mcesar67/MCboard/examples/classic_64x20/MCboard_64x20.pdf

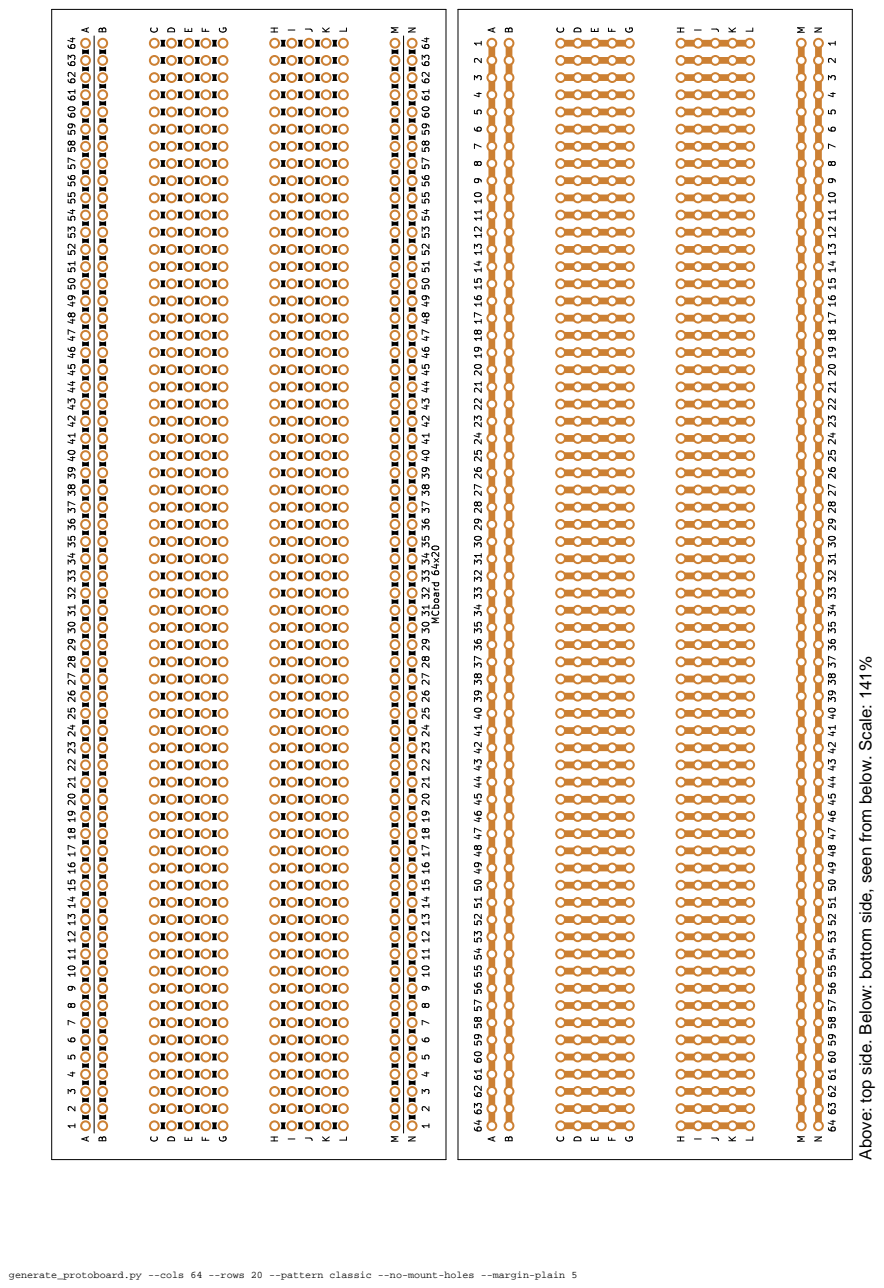
[picture p4: page 1]

Above: top side. Below: bottom side, seen from below. Scale: 141%

generate_protoboard.py --cols 64 --rows 20 --pattern classic --no-mount-holes --margin-plain 5
