mcesar67/MCboard/examples/default_30x19/MCboard_30x19.pdf

## Top and bottom: 2 holes each, centres 75 mm apart, strips 56.72 mm apart

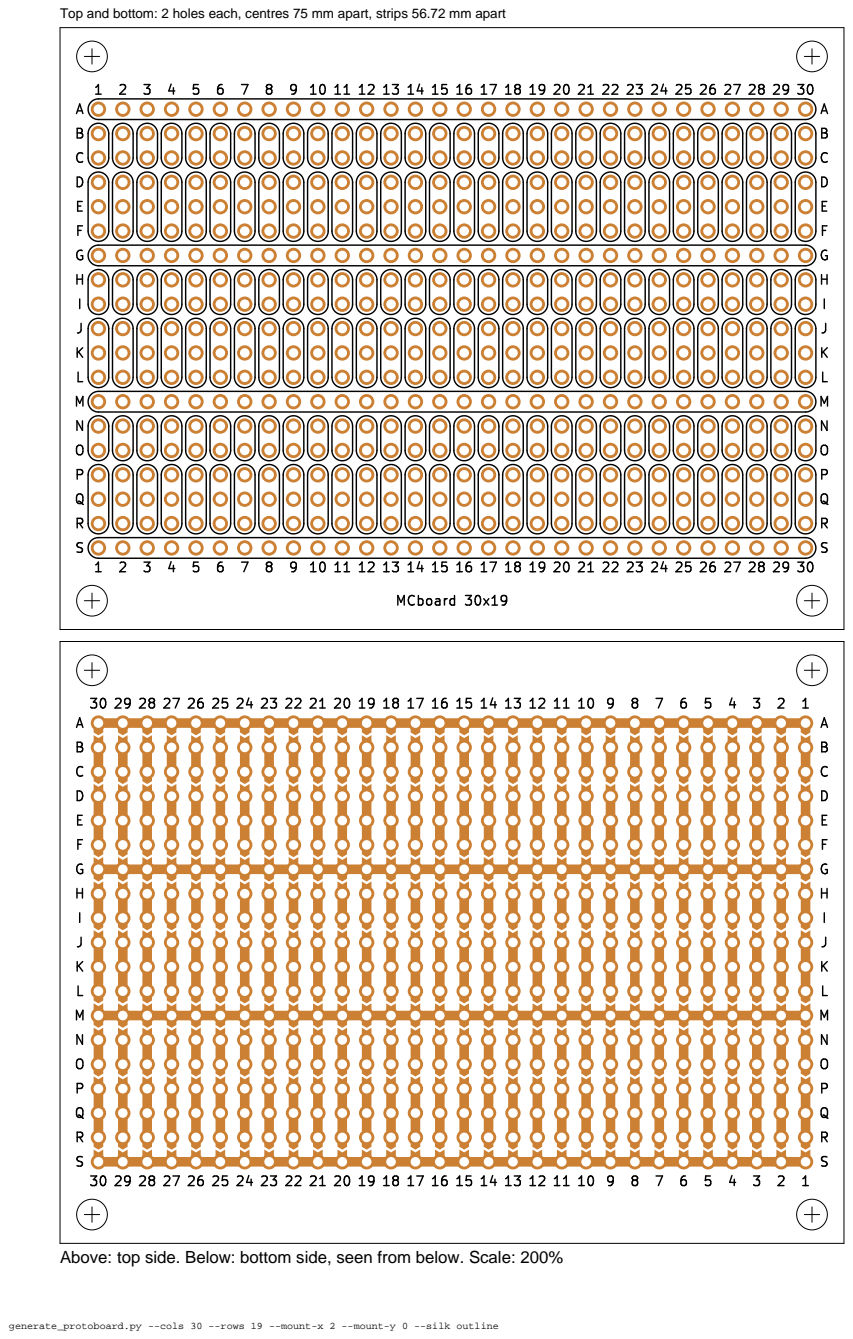
[picture p5: page 1]

Above: top side. Below: bottom side, seen from below. Scale: 200%

generate_protoboard.py --cols 30 --rows 19 --mount-x 2 --mount-y 0 --silk outline
