mcesar67/MCboard/examples/default_30x19/MCboard_30x19.kicad_pcb

## KiCad design examples/default_30x19/MCboard_30x19.kicad_pcb (2026-11-11)

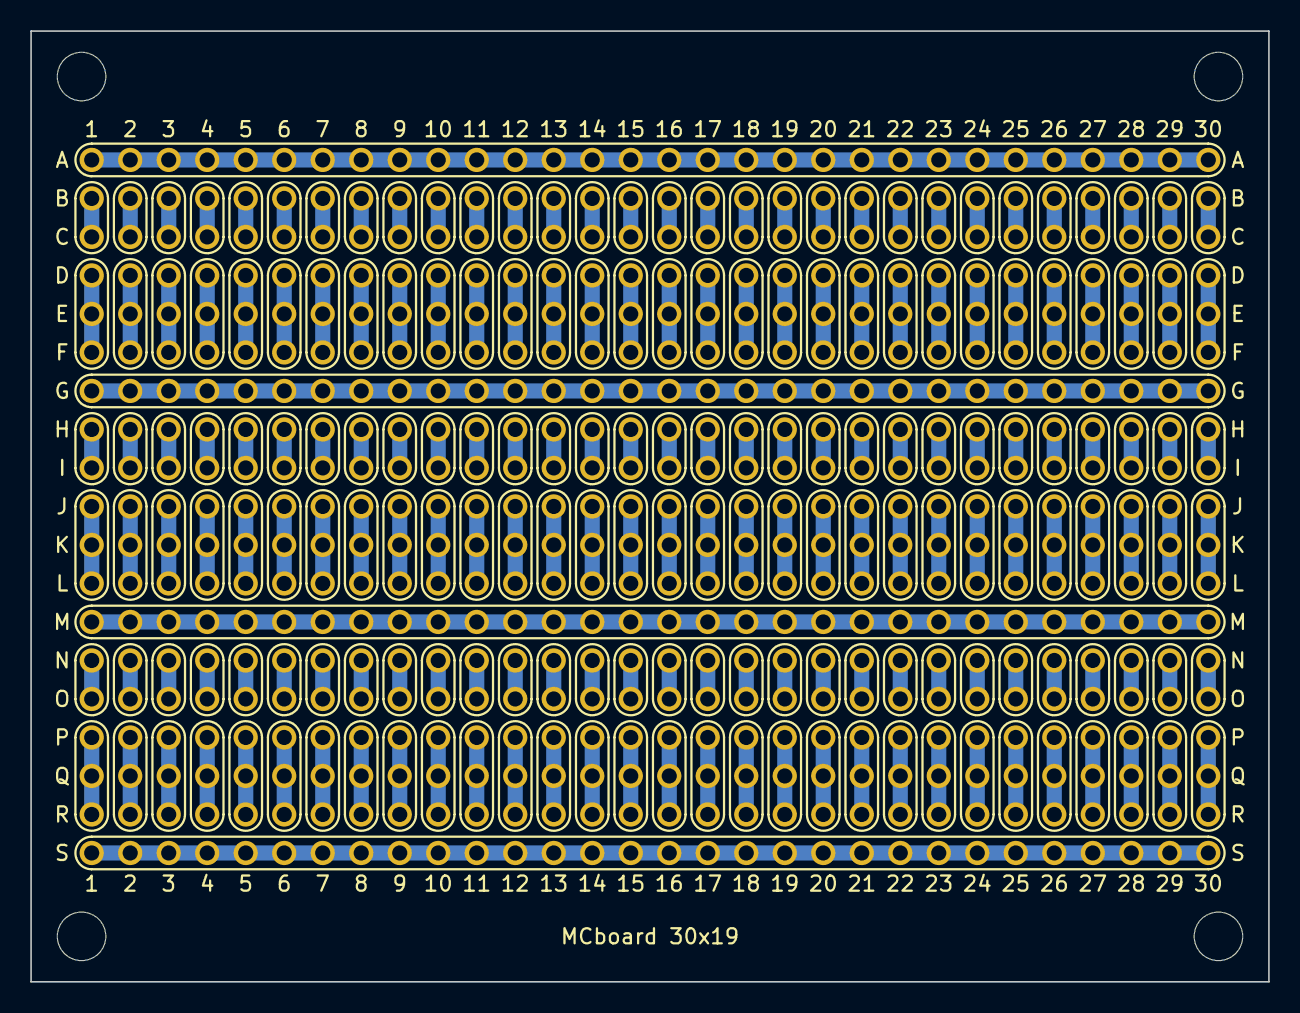
[picture p6: board examples/default_30x19/MCboard_30x19.kicad_pcb from above]

Board: 2 copper layers, 81.7 x 62.7 mm, 844 parts (0 on the bottom side), 184 nets.

Parts:
PBH1, PBH2, PBH3, PBH4, PBH5, PBH6, PBH7, PBH8, PBH9, PBH10, PBH11, PBH12, PBH13, PBH14, PBH15, PBH16, PBH17, PBH18, PBH19, PBH20, PBH21, PBH22, PBH23, PBH24, PBH25, PBH26, PBH27, PBH28, PBH29, PBH30, PBH31, PBH32, PBH33, PBH34, PBH35, PBH36, PBH37, PBH38, PBH39, PBH40, PBH41, PBH42, PBH43, PBH44, PBH45, PBH46, PBH47, PBH48, PBH49, PBH50, PBH51, PBH52, PBH53, PBH54, PBH55, PBH56, PBH57, PBH58, PBH59, PBH60, PBH61, PBH62, PBH63, PBH64, PBH65, PBH66, PBH67, PBH68, PBH69, PBH70, PBH71, PBH72, PBH73, PBH74, PBH75, PBH76, PBH77, PBH78, PBH79, PBH80, PBH81, PBH82, PBH83, PBH84, PBH85, PBH86, PBH87, PBH88, PBH89, PBH90, PBH91, PBH92, PBH93, PBH94, PBH95, PBH96, PBH97, PBH98, PBH99, PBH100, PBH101, PBH102, PBH103, PBH104, PBH105, PBH106, PBH107, PBH108, PBH109, PBH110, PBH111, PBH112, PBH113, PBH114, PBH115, PBH116, PBH117, PBH118, PBH119, PBH120, PBH121, PBH122, PBH123, PBH124, PBH125, PBH126, PBH127, PBH128, PBH129, PBH130, PBH131, PBH132, PBH133, PBH134, PBH135, PBH136, PBH137, PBH138, PBH139, PBH140, PBH141, PBH142, PBH143, PBH144, PBH145, PBH146, PBH147, PBH148, PBH149, PBH150, PBH151, PBH152, PBH153, PBH154, PBH155, PBH156, PBH157, PBH158, PBH159, PBH160, PBH161, PBH162, PBH163, PBH164, PBH165, PBH166, PBH167, PBH168, PBH169, PBH170, PBH171, PBH172, PBH173, PBH174, PBH175, PBH176, PBH177, PBH178, PBH179, PBH180, PBH181, PBH182, PBH183, PBH184, PBH185, PBH186, PBH187, PBH188, PBH189, PBH190, PBH191, PBH192, PBH193, PBH194, PBH195, PBH196, PBH197, PBH198, PBH199, PBH200, PBH201, PBH202, PBH203, PBH204, PBH205, PBH206, PBH207, PBH208, PBH209, PBH210, PBH211, PBH212, PBH213, PBH214, PBH215, PBH216, PBH217, PBH218, PBH219, PBH220, PBH221, PBH222, PBH223, PBH224, PBH225, PBH226, PBH227, PBH228, PBH229, PBH230, PBH231, PBH232, PBH233, PBH234, PBH235, PBH236, PBH237, PBH238, PBH239, PBH240, PBH241, PBH242, PBH243, PBH244, PBH245, PBH246, PBH247, PBH248, PBH249, PBH250, PBH251, PBH252, PBH253, PBH254, PBH255, PBH256, PBH257, PBH258, PBH259, PBH260, PBH261, PBH262, PBH263, PBH264, PBH265, PBH266, PBH267, PBH268, PBH269, PBH270, PBH271, PBH272, PBH273, PBH274, PBH275, PBH276, PBH277, PBH278, PBH279, PBH280, PBH281, PBH282, PBH283, PBH284, PBH285, PBH286, PBH287, PBH288, PBH289, PBH290, PBH291, PBH292, PBH293, PBH294, PBH295, PBH296, PBH297, PBH298, PBH299, PBH300, PBH301, PBH302, PBH303, PBH304, PBH305, PBH306, PBH307, PBH308, PBH309, PBH310, PBH311, PBH312, PBH313, PBH314, PBH315, PBH316, PBH317, PBH318, PBH319, PBH320, PBH321, PBH322, PBH323, PBH324, PBH325, PBH326, PBH327, PBH328, PBH329, PBH330, PBH331, PBH332, PBH333, PBH334, PBH335, PBH336, PBH337, PBH338, PBH339, PBH340, PBH341, PBH342, PBH343, PBH344, PBH345, PBH346, PBH347, PBH348, PBH349, PBH350, PBH351, PBH352, PBH353, PBH354, PBH355, PBH356, PBH357, PBH358, PBH359, PBH360, PBH361, PBH362, PBH363, PBH364, PBH365, PBH366, PBH367, PBH368, PBH369, PBH370, PBH371, PBH372, PBH373, PBH374, PBH375, PBH376, PBH377, PBH378, PBH379, PBH380, PBH381, PBH382, PBH383, PBH384, PBH385, PBH386, PBH387, PBH388, PBH389, PBH390, PBH391, PBH392, PBH393, PBH394, PBH395, PBH396, PBH397, PBH398, PBH399, PBH400, PBH401, PBH402, PBH403, PBH404, PBH405, PBH406, PBH407, PBH408, PBH409, PBH410, PBH411, PBH412, PBH413, PBH414, PBH415, PBH416, PBH417, PBH418, PBH419, PBH420, PBH421, PBH422, PBH423, PBH424, PBH425, PBH426, PBH427, PBH428, PBH429, PBH430, PBH431, PBH432, PBH433, PBH434, PBH435, PBH436, PBH437, PBH438, PBH439, PBH440, PBH441, PBH442, PBH443, PBH444, PBH445, PBH446, PBH447, PBH448, PBH449, PBH450, PBH451, PBH452, PBH453, PBH454, PBH455, PBH456, PBH457, PBH458, PBH459, PBH460, PBH461, PBH462, PBH463, PBH464, PBH465, PBH466, PBH467, PBH468, PBH469, PBH470, PBH471, PBH472, PBH473, PBH474, PBH475, PBH476, PBH477, PBH478, PBH479, PBH480, PBH481, PBH482, PBH483, PBH484, PBH485, PBH486, PBH487, PBH488, PBH489, PBH490, PBH491, PBH492, PBH493, PBH494, PBH495, PBH496, PBH497, PBH498, PBH499, PBH500, PBH501, PBH502, PBH503, PBH504, PBH505, PBH506, PBH507, PBH508, PBH509, PBH510, PBH511, PBH512, PBH513, PBH514, PBH515, PBH516, PBH517, PBH518, PBH519, PBH520, PBH521, PBH522, PBH523, PBH524, PBH525, PBH526, PBH527, PBH528, PBH529, PBH530, PBH531, PBH532, PBH533, PBH534, PBH535, PBH536, PBH537, PBH538, PBH539, PBH540, PBH541, PBH542, PBH543, PBH544, PBH545, PBH546, PBH547, PBH548, PBH549, PBH550, PBH551, PBH552, PBH553, PBH554, PBH555, PBH556, PBH557, PBH558, PBH559, PBH560, PBH561, PBH562, PBH563, PBH564, PBH565, PBH566, PBH567, PBH568, PBH569, PBH570: hole; Hole
PBJP1, PBJP2, PBJP3, PBJP4, PBJP5, PBJP6, PBJP7, PBJP8, PBJP9, PBJP10, PBJP11, PBJP12, PBJP13, PBJP14, PBJP15, PBJP16, PBJP17, PBJP18, PBJP19, PBJP20, PBJP21, PBJP22, PBJP23, PBJP24, PBJP25, PBJP26, PBJP27, PBJP28, PBJP29, PBJP30, PBJP31, PBJP32, PBJP33, PBJP34, PBJP35, PBJP36, PBJP37, PBJP38, PBJP39, PBJP40, PBJP41, PBJP42, PBJP43, PBJP44, PBJP45, PBJP46, PBJP47, PBJP48, PBJP49, PBJP50, PBJP51, PBJP52, PBJP53, PBJP54, PBJP55, PBJP56, PBJP57, PBJP58, PBJP59, PBJP60, PBJP61, PBJP62, PBJP63, PBJP64, PBJP65, PBJP66, PBJP67, PBJP68, PBJP69, PBJP70, PBJP71, PBJP72, PBJP73, PBJP74, PBJP75, PBJP76, PBJP77, PBJP78, PBJP79, PBJP80, PBJP81, PBJP82, PBJP83, PBJP84, PBJP85, PBJP86, PBJP87, PBJP88, PBJP89, PBJP90, PBJP91, PBJP92, PBJP93, PBJP94, PBJP95, PBJP96, PBJP97, PBJP98, PBJP99, PBJP100, PBJP101, PBJP102, PBJP103, PBJP104, PBJP105, PBJP106, PBJP107, PBJP108, PBJP109, PBJP110, PBJP111, PBJP112, PBJP113, PBJP114, PBJP115, PBJP116, PBJP117, PBJP118, PBJP119, PBJP120, PBJP121, PBJP122, PBJP123, PBJP124, PBJP125, PBJP126, PBJP127, PBJP128, PBJP129, PBJP130, PBJP131, PBJP132, PBJP133, PBJP134, PBJP135, PBJP136, PBJP137, PBJP138, PBJP139, PBJP140, PBJP141, PBJP142, PBJP143, PBJP144, PBJP145, PBJP146, PBJP147, PBJP148, PBJP149, PBJP150, PBJP151, PBJP152, PBJP153, PBJP154, PBJP155, PBJP156, PBJP157, PBJP158, PBJP159, PBJP160, PBJP161, PBJP162, PBJP163, PBJP164, PBJP165, PBJP166, PBJP167, PBJP168, PBJP169, PBJP170, PBJP171, PBJP172, PBJP173, PBJP174, PBJP175, PBJP176, PBJP177, PBJP178, PBJP179, PBJP180, PBJP181, PBJP182, PBJP183, PBJP184, PBJP185, PBJP186, PBJP187, PBJP188, PBJP189, PBJP190, PBJP191, PBJP192, PBJP193, PBJP194, PBJP195, PBJP196, PBJP197, PBJP198, PBJP199, PBJP200, PBJP201, PBJP202, PBJP203, PBJP204, PBJP205, PBJP206, PBJP207, PBJP208, PBJP209, PBJP210, PBJP211, PBJP212, PBJP213, PBJP214, PBJP215, PBJP216, PBJP217, PBJP218, PBJP219, PBJP220, PBJP221, PBJP222, PBJP223, PBJP224, PBJP225, PBJP226, PBJP227, PBJP228, PBJP229, PBJP230, PBJP231, PBJP232, PBJP233, PBJP234, PBJP235, PBJP236, PBJP237, PBJP238, PBJP239, PBJP240, PBJP241, PBJP242, PBJP243, PBJP244, PBJP245, PBJP246, PBJP247, PBJP248, PBJP249, PBJP250, PBJP251, PBJP252, PBJP253, PBJP254, PBJP255, PBJP256, PBJP257, PBJP258, PBJP259, PBJP260, PBJP261, PBJP262, PBJP263, PBJP264, PBJP265, PBJP266, PBJP267, PBJP268, PBJP269, PBJP270: chevron; ChevronJumper
PBMH1, PBMH2, PBMH3, PBMH4: mounting hole; MountingHole

Connections:
BUS_R1: PBH1.1, PBH20.1, PBH39.1, PBH58.1, PBH77.1, PBH96.1, PBH115.1, PBH134.1, PBH153.1, PBH172.1, PBH191.1, PBH210.1, PBH229.1, PBH248.1, PBH267.1, PBH286.1, PBH305.1, PBH324.1, PBH343.1, PBH362.1, PBH381.1, PBH400.1, PBH419.1, PBH438.1, PBH457.1, PBH476.1, PBH495.1, PBH514.1, PBH533.1, PBH552.1, PBJP1.1, PBJP10.1, PBJP19.1, PBJP28.1, PBJP37.1, PBJP46.1, PBJP55.1, PBJP64.1, PBJP73.1, PBJP82.1, PBJP91.1, PBJP100.1, PBJP109.1, PBJP118.1, PBJP127.1, PBJP136.1, PBJP145.1, PBJP154.1, PBJP163.1, PBJP172.1, PBJP181.1, PBJP190.1, PBJP199.1, PBJP208.1, PBJP217.1, PBJP226.1, PBJP235.1, PBJP244.1, PBJP253.1, PBJP262.1
BUS_R7: PBH7.1, PBH26.1, PBH45.1, PBH64.1, PBH83.1, PBH102.1, PBH121.1, PBH140.1, PBH159.1, PBH178.1, PBH197.1, PBH216.1, PBH235.1, PBH254.1, PBH273.1, PBH292.1, PBH311.1, PBH330.1, PBH349.1, PBH368.1, PBH387.1, PBH406.1, PBH425.1, PBH444.1, PBH463.1, PBH482.1, PBH501.1, PBH520.1, PBH539.1, PBH558.1, PBJP3.2, PBJP4.1, PBJP12.2, PBJP13.1, PBJP21.2, PBJP22.1, PBJP30.2, PBJP31.1, PBJP39.2, PBJP40.1, PBJP48.2, PBJP49.1, PBJP57.2, PBJP58.1, PBJP66.2, PBJP67.1, PBJP75.2, PBJP76.1, PBJP84.2, PBJP85.1, PBJP93.2, PBJP94.1, PBJP102.2, PBJP103.1, PBJP111.2, PBJP112.1, PBJP120.2, PBJP121.1, PBJP129.2, PBJP130.1, PBJP138.2, PBJP139.1, PBJP147.2, PBJP148.1, PBJP156.2, PBJP157.1, PBJP165.2, PBJP166.1, PBJP174.2, PBJP175.1, PBJP183.2, PBJP184.1, PBJP192.2, PBJP193.1, PBJP201.2, PBJP202.1, PBJP210.2, PBJP211.1, PBJP219.2, PBJP220.1, PBJP228.2, PBJP229.1, PBJP237.2, PBJP238.1, PBJP246.2, PBJP247.1, PBJP255.2, PBJP256.1, PBJP264.2, PBJP265.1
BUS_R13: PBH13.1, PBH32.1, PBH51.1, PBH70.1, PBH89.1, PBH108.1, PBH127.1, PBH146.1, PBH165.1, PBH184.1, PBH203.1, PBH222.1, PBH241.1, PBH260.1, PBH279.1, PBH298.1, PBH317.1, PBH336.1, PBH355.1, PBH374.1, PBH393.1, PBH412.1, PBH431.1, PBH450.1, PBH469.1, PBH488.1, PBH507.1, PBH526.1, PBH545.1, PBH564.1, PBJP6.2, PBJP7.1, PBJP15.2, PBJP16.1, PBJP24.2, PBJP25.1, PBJP33.2, PBJP34.1, PBJP42.2, PBJP43.1, PBJP51.2, PBJP52.1, PBJP60.2, PBJP61.1, PBJP69.2, PBJP70.1, PBJP78.2, PBJP79.1, PBJP87.2, PBJP88.1, PBJP96.2, PBJP97.1, PBJP105.2, PBJP106.1, PBJP114.2, PBJP115.1, PBJP123.2, PBJP124.1, PBJP132.2, PBJP133.1, PBJP141.2, PBJP142.1, PBJP150.2, PBJP151.1, PBJP159.2, PBJP160.1, PBJP168.2, PBJP169.1, PBJP177.2, PBJP178.1, PBJP186.2, PBJP187.1, PBJP195.2, PBJP196.1, PBJP204.2, PBJP205.1, PBJP213.2, PBJP214.1, PBJP222.2, PBJP223.1, PBJP231.2, PBJP232.1, PBJP240.2, PBJP241.1, PBJP249.2, PBJP250.1, PBJP258.2, PBJP259.1, PBJP267.2, PBJP268.1
BUS_R19: PBH19.1, PBH38.1, PBH57.1, PBH76.1, PBH95.1, PBH114.1, PBH133.1, PBH152.1, PBH171.1, PBH190.1, PBH209.1, PBH228.1, PBH247.1, PBH266.1, PBH285.1, PBH304.1, PBH323.1, PBH342.1, PBH361.1, PBH380.1, PBH399.1, PBH418.1, PBH437.1, PBH456.1, PBH475.1, PBH494.1, PBH513.1, PBH532.1, PBH551.1, PBH570.1, PBJP9.2, PBJP18.2, PBJP27.2, PBJP36.2, PBJP45.2, PBJP54.2, PBJP63.2, PBJP72.2, PBJP81.2, PBJP90.2, PBJP99.2, PBJP108.2, PBJP117.2, PBJP126.2, PBJP135.2, PBJP144.2, PBJP153.2, PBJP162.2, PBJP171.2, PBJP180.2, PBJP189.2, PBJP198.2, PBJP207.2, PBJP216.2, PBJP225.2, PBJP234.2, PBJP243.2, PBJP252.2, PBJP261.2, PBJP270.2
C1_R2: PBH2.1, PBH3.1, PBJP1.2, PBJP2.1
C1_R4: PBH4.1, PBH5.1, PBH6.1, PBJP2.2, PBJP3.1
C1_R8: PBH8.1, PBH9.1, PBJP4.2, PBJP5.1
C1_R10: PBH10.1, PBH11.1, PBH12.1, PBJP5.2, PBJP6.1
C1_R14: PBH14.1, PBH15.1, PBJP7.2, PBJP8.1
C1_R16: PBH16.1, PBH17.1, PBH18.1, PBJP8.2, PBJP9.1
C2_R2: PBH21.1, PBH22.1, PBJP10.2, PBJP11.1
C2_R4: PBH23.1, PBH24.1, PBH25.1, PBJP11.2, PBJP12.1
C2_R8: PBH27.1, PBH28.1, PBJP13.2, PBJP14.1
C2_R10: PBH29.1, PBH30.1, PBH31.1, PBJP14.2, PBJP15.1
C2_R14: PBH33.1, PBH34.1, PBJP16.2, PBJP17.1
C2_R16: PBH35.1, PBH36.1, PBH37.1, PBJP17.2, PBJP18.1
C3_R2: PBH40.1, PBH41.1, PBJP19.2, PBJP20.1
C3_R4: PBH42.1, PBH43.1, PBH44.1, PBJP20.2, PBJP21.1
C3_R8: PBH46.1, PBH47.1, PBJP22.2, PBJP23.1
C3_R10: PBH48.1, PBH49.1, PBH50.1, PBJP23.2, PBJP24.1
C3_R14: PBH52.1, PBH53.1, PBJP25.2, PBJP26.1
C3_R16: PBH54.1, PBH55.1, PBH56.1, PBJP26.2, PBJP27.1
C4_R2: PBH59.1, PBH60.1, PBJP28.2, PBJP29.1
C4_R4: PBH61.1, PBH62.1, PBH63.1, PBJP29.2, PBJP30.1
C4_R8: PBH65.1, PBH66.1, PBJP31.2, PBJP32.1
C4_R10: PBH67.1, PBH68.1, PBH69.1, PBJP32.2, PBJP33.1
C4_R14: PBH71.1, PBH72.1, PBJP34.2, PBJP35.1
C4_R16: PBH73.1, PBH74.1, PBH75.1, PBJP35.2, PBJP36.1
C5_R2: PBH78.1, PBH79.1, PBJP37.2, PBJP38.1
C5_R4: PBH80.1, PBH81.1, PBH82.1, PBJP38.2, PBJP39.1
C5_R8: PBH84.1, PBH85.1, PBJP40.2, PBJP41.1
C5_R10: PBH86.1, PBH87.1, PBH88.1, PBJP41.2, PBJP42.1
C5_R14: PBH90.1, PBH91.1, PBJP43.2, PBJP44.1
C5_R16: PBH92.1, PBH93.1, PBH94.1, PBJP44.2, PBJP45.1
C6_R2: PBH97.1, PBH98.1, PBJP46.2, PBJP47.1
C6_R4: PBH99.1, PBH100.1, PBH101.1, PBJP47.2, PBJP48.1
C6_R8: PBH103.1, PBH104.1, PBJP49.2, PBJP50.1
C6_R10: PBH105.1, PBH106.1, PBH107.1, PBJP50.2, PBJP51.1
C6_R14: PBH109.1, PBH110.1, PBJP52.2, PBJP53.1
C6_R16: PBH111.1, PBH112.1, PBH113.1, PBJP53.2, PBJP54.1
C7_R2: PBH116.1, PBH117.1, PBJP55.2, PBJP56.1
C7_R4: PBH118.1, PBH119.1, PBH120.1, PBJP56.2, PBJP57.1
C7_R8: PBH122.1, PBH123.1, PBJP58.2, PBJP59.1
C7_R10: PBH124.1, PBH125.1, PBH126.1, PBJP59.2, PBJP60.1
C7_R14: PBH128.1, PBH129.1, PBJP61.2, PBJP62.1
C7_R16: PBH130.1, PBH131.1, PBH132.1, PBJP62.2, PBJP63.1
C8_R2: PBH135.1, PBH136.1, PBJP64.2, PBJP65.1
C8_R4: PBH137.1, PBH138.1, PBH139.1, PBJP65.2, PBJP66.1
C8_R8: PBH141.1, PBH142.1, PBJP67.2, PBJP68.1
C8_R10: PBH143.1, PBH144.1, PBH145.1, PBJP68.2, PBJP69.1
C8_R14: PBH147.1, PBH148.1, PBJP70.2, PBJP71.1
C8_R16: PBH149.1, PBH150.1, PBH151.1, PBJP71.2, PBJP72.1
C9_R2: PBH154.1, PBH155.1, PBJP73.2, PBJP74.1
C9_R4: PBH156.1, PBH157.1, PBH158.1, PBJP74.2, PBJP75.1
C9_R8: PBH160.1, PBH161.1, PBJP76.2, PBJP77.1
C9_R10: PBH162.1, PBH163.1, PBH164.1, PBJP77.2, PBJP78.1
C9_R14: PBH166.1, PBH167.1, PBJP79.2, PBJP80.1
C9_R16: PBH168.1, PBH169.1, PBH170.1, PBJP80.2, PBJP81.1
C10_R2: PBH173.1, PBH174.1, PBJP82.2, PBJP83.1
C10_R4: PBH175.1, PBH176.1, PBH177.1, PBJP83.2, PBJP84.1
C10_R8: PBH179.1, PBH180.1, PBJP85.2, PBJP86.1
C10_R10: PBH181.1, PBH182.1, PBH183.1, PBJP86.2, PBJP87.1
C10_R14: PBH185.1, PBH186.1, PBJP88.2, PBJP89.1
C10_R16: PBH187.1, PBH188.1, PBH189.1, PBJP89.2, PBJP90.1
C11_R2: PBH192.1, PBH193.1, PBJP91.2, PBJP92.1
C11_R4: PBH194.1, PBH195.1, PBH196.1, PBJP92.2, PBJP93.1
C11_R8: PBH198.1, PBH199.1, PBJP94.2, PBJP95.1
C11_R10: PBH200.1, PBH201.1, PBH202.1, PBJP95.2, PBJP96.1
C11_R14: PBH204.1, PBH205.1, PBJP97.2, PBJP98.1
C11_R16: PBH206.1, PBH207.1, PBH208.1, PBJP98.2, PBJP99.1
C12_R2: PBH211.1, PBH212.1, PBJP100.2, PBJP101.1
C12_R4: PBH213.1, PBH214.1, PBH215.1, PBJP101.2, PBJP102.1
C12_R8: PBH217.1, PBH218.1, PBJP103.2, PBJP104.1
C12_R10: PBH219.1, PBH220.1, PBH221.1, PBJP104.2, PBJP105.1
C12_R14: PBH223.1, PBH224.1, PBJP106.2, PBJP107.1
C12_R16: PBH225.1, PBH226.1, PBH227.1, PBJP107.2, PBJP108.1
C13_R2: PBH230.1, PBH231.1, PBJP109.2, PBJP110.1
C13_R4: PBH232.1, PBH233.1, PBH234.1, PBJP110.2, PBJP111.1
C13_R8: PBH236.1, PBH237.1, PBJP112.2, PBJP113.1
C13_R10: PBH238.1, PBH239.1, PBH240.1, PBJP113.2, PBJP114.1
C13_R14: PBH242.1, PBH243.1, PBJP115.2, PBJP116.1
C13_R16: PBH244.1, PBH245.1, PBH246.1, PBJP116.2, PBJP117.1
C14_R2: PBH249.1, PBH250.1, PBJP118.2, PBJP119.1
C14_R4: PBH251.1, PBH252.1, PBH253.1, PBJP119.2, PBJP120.1
C14_R8: PBH255.1, PBH256.1, PBJP121.2, PBJP122.1
C14_R10: PBH257.1, PBH258.1, PBH259.1, PBJP122.2, PBJP123.1
C14_R14: PBH261.1, PBH262.1, PBJP124.2, PBJP125.1
C14_R16: PBH263.1, PBH264.1, PBH265.1, PBJP125.2, PBJP126.1
C15_R2: PBH268.1, PBH269.1, PBJP127.2, PBJP128.1
C15_R4: PBH270.1, PBH271.1, PBH272.1, PBJP128.2, PBJP129.1
C15_R8: PBH274.1, PBH275.1, PBJP130.2, PBJP131.1
C15_R10: PBH276.1, PBH277.1, PBH278.1, PBJP131.2, PBJP132.1
C15_R14: PBH280.1, PBH281.1, PBJP133.2, PBJP134.1
C15_R16: PBH282.1, PBH283.1, PBH284.1, PBJP134.2, PBJP135.1
C16_R2: PBH287.1, PBH288.1, PBJP136.2, PBJP137.1
C16_R4: PBH289.1, PBH290.1, PBH291.1, PBJP137.2, PBJP138.1
C16_R8: PBH293.1, PBH294.1, PBJP139.2, PBJP140.1
C16_R10: PBH295.1, PBH296.1, PBH297.1, PBJP140.2, PBJP141.1
C16_R14: PBH299.1, PBH300.1, PBJP142.2, PBJP143.1
C16_R16: PBH301.1, PBH302.1, PBH303.1, PBJP143.2, PBJP144.1
C17_R2: PBH306.1, PBH307.1, PBJP145.2, PBJP146.1
C17_R4: PBH308.1, PBH309.1, PBH310.1, PBJP146.2, PBJP147.1
C17_R8: PBH312.1, PBH313.1, PBJP148.2, PBJP149.1
C17_R10: PBH314.1, PBH315.1, PBH316.1, PBJP149.2, PBJP150.1
C17_R14: PBH318.1, PBH319.1, PBJP151.2, PBJP152.1
C17_R16: PBH320.1, PBH321.1, PBH322.1, PBJP152.2, PBJP153.1
C18_R2: PBH325.1, PBH326.1, PBJP154.2, PBJP155.1
C18_R4: PBH327.1, PBH328.1, PBH329.1, PBJP155.2, PBJP156.1
C18_R8: PBH331.1, PBH332.1, PBJP157.2, PBJP158.1
C18_R10: PBH333.1, PBH334.1, PBH335.1, PBJP158.2, PBJP159.1
C18_R14: PBH337.1, PBH338.1, PBJP160.2, PBJP161.1
C18_R16: PBH339.1, PBH340.1, PBH341.1, PBJP161.2, PBJP162.1
C19_R2: PBH344.1, PBH345.1, PBJP163.2, PBJP164.1
C19_R4: PBH346.1, PBH347.1, PBH348.1, PBJP164.2, PBJP165.1
C19_R8: PBH350.1, PBH351.1, PBJP166.2, PBJP167.1
C19_R10: PBH352.1, PBH353.1, PBH354.1, PBJP167.2, PBJP168.1
C19_R14: PBH356.1, PBH357.1, PBJP169.2, PBJP170.1
C19_R16: PBH358.1, PBH359.1, PBH360.1, PBJP170.2, PBJP171.1
C20_R2: PBH363.1, PBH364.1, PBJP172.2, PBJP173.1
C20_R4: PBH365.1, PBH366.1, PBH367.1, PBJP173.2, PBJP174.1
C20_R8: PBH369.1, PBH370.1, PBJP175.2, PBJP176.1
C20_R10: PBH371.1, PBH372.1, PBH373.1, PBJP176.2, PBJP177.1
C20_R14: PBH375.1, PBH376.1, PBJP178.2, PBJP179.1
C20_R16: PBH377.1, PBH378.1, PBH379.1, PBJP179.2, PBJP180.1
C21_R2: PBH382.1, PBH383.1, PBJP181.2, PBJP182.1
C21_R4: PBH384.1, PBH385.1, PBH386.1, PBJP182.2, PBJP183.1
C21_R8: PBH388.1, PBH389.1, PBJP184.2, PBJP185.1
C21_R10: PBH390.1, PBH391.1, PBH392.1, PBJP185.2, PBJP186.1
C21_R14: PBH394.1, PBH395.1, PBJP187.2, PBJP188.1
C21_R16: PBH396.1, PBH397.1, PBH398.1, PBJP188.2, PBJP189.1
C22_R2: PBH401.1, PBH402.1, PBJP190.2, PBJP191.1
C22_R4: PBH403.1, PBH404.1, PBH405.1, PBJP191.2, PBJP192.1
C22_R8: PBH407.1, PBH408.1, PBJP193.2, PBJP194.1
C22_R10: PBH409.1, PBH410.1, PBH411.1, PBJP194.2, PBJP195.1
C22_R14: PBH413.1, PBH414.1, PBJP196.2, PBJP197.1
C22_R16: PBH415.1, PBH416.1, PBH417.1, PBJP197.2, PBJP198.1
C23_R2: PBH420.1, PBH421.1, PBJP199.2, PBJP200.1
C23_R4: PBH422.1, PBH423.1, PBH424.1, PBJP200.2, PBJP201.1
C23_R8: PBH426.1, PBH427.1, PBJP202.2, PBJP203.1
C23_R10: PBH428.1, PBH429.1, PBH430.1, PBJP203.2, PBJP204.1
C23_R14: PBH432.1, PBH433.1, PBJP205.2, PBJP206.1
C23_R16: PBH434.1, PBH435.1, PBH436.1, PBJP206.2, PBJP207.1
C24_R2: PBH439.1, PBH440.1, PBJP208.2, PBJP209.1
C24_R4: PBH441.1, PBH442.1, PBH443.1, PBJP209.2, PBJP210.1
C24_R8: PBH445.1, PBH446.1, PBJP211.2, PBJP212.1
C24_R10: PBH447.1, PBH448.1, PBH449.1, PBJP212.2, PBJP213.1
C24_R14: PBH451.1, PBH452.1, PBJP214.2, PBJP215.1
C24_R16: PBH453.1, PBH454.1, PBH455.1, PBJP215.2, PBJP216.1
C25_R2: PBH458.1, PBH459.1, PBJP217.2, PBJP218.1
C25_R4: PBH460.1, PBH461.1, PBH462.1, PBJP218.2, PBJP219.1
C25_R8: PBH464.1, PBH465.1, PBJP220.2, PBJP221.1
C25_R10: PBH466.1, PBH467.1, PBH468.1, PBJP221.2, PBJP222.1
C25_R14: PBH470.1, PBH471.1, PBJP223.2, PBJP224.1
C25_R16: PBH472.1, PBH473.1, PBH474.1, PBJP224.2, PBJP225.1
C26_R2: PBH477.1, PBH478.1, PBJP226.2, PBJP227.1
C26_R4: PBH479.1, PBH480.1, PBH481.1, PBJP227.2, PBJP228.1
C26_R8: PBH483.1, PBH484.1, PBJP229.2, PBJP230.1
C26_R10: PBH485.1, PBH486.1, PBH487.1, PBJP230.2, PBJP231.1
C26_R14: PBH489.1, PBH490.1, PBJP232.2, PBJP233.1
C26_R16: PBH491.1, PBH492.1, PBH493.1, PBJP233.2, PBJP234.1
C27_R2: PBH496.1, PBH497.1, PBJP235.2, PBJP236.1
C27_R4: PBH498.1, PBH499.1, PBH500.1, PBJP236.2, PBJP237.1
C27_R8: PBH502.1, PBH503.1, PBJP238.2, PBJP239.1
C27_R10: PBH504.1, PBH505.1, PBH506.1, PBJP239.2, PBJP240.1
C27_R14: PBH508.1, PBH509.1, PBJP241.2, PBJP242.1
C27_R16: PBH510.1, PBH511.1, PBH512.1, PBJP242.2, PBJP243.1
C28_R2: PBH515.1, PBH516.1, PBJP244.2, PBJP245.1
C28_R4: PBH517.1, PBH518.1, PBH519.1, PBJP245.2, PBJP246.1
C28_R8: PBH521.1, PBH522.1, PBJP247.2, PBJP248.1
C28_R10: PBH523.1, PBH524.1, PBH525.1, PBJP248.2, PBJP249.1
C28_R14: PBH527.1, PBH528.1, PBJP250.2, PBJP251.1
C28_R16: PBH529.1, PBH530.1, PBH531.1, PBJP251.2, PBJP252.1
C29_R2: PBH534.1, PBH535.1, PBJP253.2, PBJP254.1
C29_R4: PBH536.1, PBH537.1, PBH538.1, PBJP254.2, PBJP255.1
C29_R8: PBH540.1, PBH541.1, PBJP256.2, PBJP257.1
C29_R10: PBH542.1, PBH543.1, PBH544.1, PBJP257.2, PBJP258.1
C29_R14: PBH546.1, PBH547.1, PBJP259.2, PBJP260.1
C29_R16: PBH548.1, PBH549.1, PBH550.1, PBJP260.2, PBJP261.1
C30_R2: PBH553.1, PBH554.1, PBJP262.2, PBJP263.1
C30_R4: PBH555.1, PBH556.1, PBH557.1, PBJP263.2, PBJP264.1
C30_R8: PBH559.1, PBH560.1, PBJP265.2, PBJP266.1
C30_R10: PBH561.1, PBH562.1, PBH563.1, PBJP266.2, PBJP267.1
C30_R14: PBH565.1, PBH566.1, PBJP268.2, PBJP269.1
C30_R16: PBH567.1, PBH568.1, PBH569.1, PBJP269.2, PBJP270.1
