mcesar67/MCboard/examples/smt_30x19/MCboard_30x19.kicad_pcb

## KiCad design examples/smt_30x19/MCboard_30x19.kicad_pcb (2026-11-11)

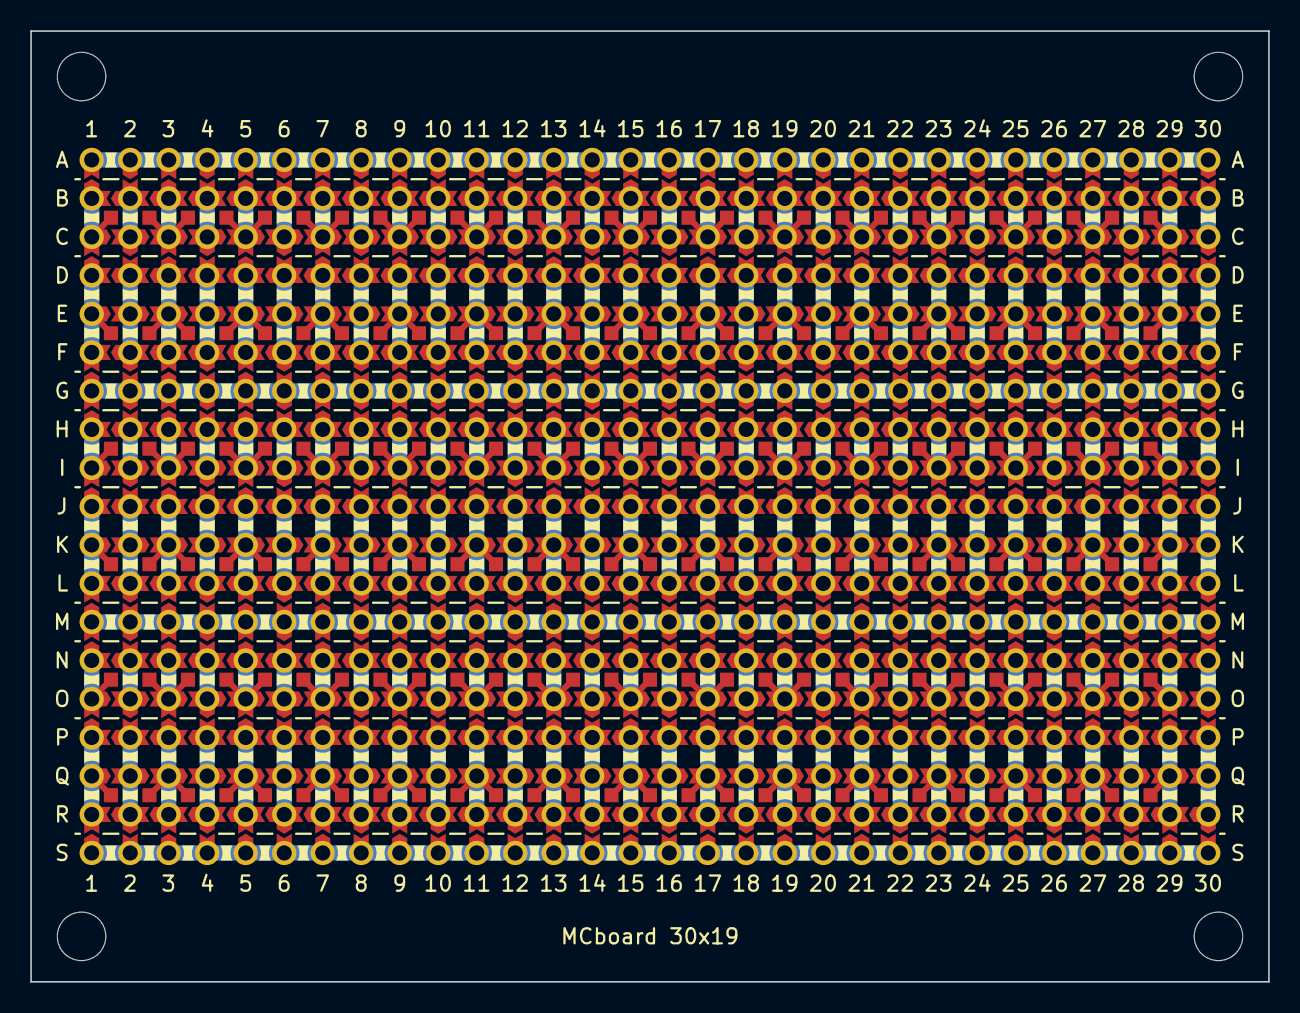
[picture p7: board examples/smt_30x19/MCboard_30x19.kicad_pcb from above]

Board: 2 copper layers, 81.7 x 62.7 mm, 1717 parts (0 on the bottom side), 184 nets.

Parts:
PBH1, PBH2, PBH3, PBH4, PBH5, PBH6, PBH7, PBH8, PBH9, PBH10, PBH11, PBH12, PBH13, PBH14, PBH15, PBH16, PBH17, PBH18, PBH19, PBH20, PBH21, PBH22, PBH23, PBH24, PBH25, PBH26, PBH27, PBH28, PBH29, PBH30, PBH31, PBH32, PBH33, PBH34, PBH35, PBH36, PBH37, PBH38, PBH39, PBH40, PBH41, PBH42, PBH43, PBH44, PBH45, PBH46, PBH47, PBH48, PBH49, PBH50, PBH51, PBH52, PBH53, PBH54, PBH55, PBH56, PBH57, PBH58, PBH59, PBH60, PBH61, PBH62, PBH63, PBH64, PBH65, PBH66, PBH67, PBH68, PBH69, PBH70, PBH71, PBH72, PBH73, PBH74, PBH75, PBH76, PBH77, PBH78, PBH79, PBH80, PBH81, PBH82, PBH83, PBH84, PBH85, PBH86, PBH87, PBH88, PBH89, PBH90, PBH91, PBH92, PBH93, PBH94, PBH95, PBH96, PBH97, PBH98, PBH99, PBH100, PBH101, PBH102, PBH103, PBH104, PBH105, PBH106, PBH107, PBH108, PBH109, PBH110, PBH111, PBH112, PBH113, PBH114, PBH115, PBH116, PBH117, PBH118, PBH119, PBH120, PBH121, PBH122, PBH123, PBH124, PBH125, PBH126, PBH127, PBH128, PBH129, PBH130, PBH131, PBH132, PBH133, PBH134, PBH135, PBH136, PBH137, PBH138, PBH139, PBH140, PBH141, PBH142, PBH143, PBH144, PBH145, PBH146, PBH147, PBH148, PBH149, PBH150, PBH151, PBH152, PBH153, PBH154, PBH155, PBH156, PBH157, PBH158, PBH159, PBH160, PBH161, PBH162, PBH163, PBH164, PBH165, PBH166, PBH167, PBH168, PBH169, PBH170, PBH171, PBH172, PBH173, PBH174, PBH175, PBH176, PBH177, PBH178, PBH179, PBH180, PBH181, PBH182, PBH183, PBH184, PBH185, PBH186, PBH187, PBH188, PBH189, PBH190, PBH191, PBH192, PBH193, PBH194, PBH195, PBH196, PBH197, PBH198, PBH199, PBH200, PBH201, PBH202, PBH203, PBH204, PBH205, PBH206, PBH207, PBH208, PBH209, PBH210, PBH211, PBH212, PBH213, PBH214, PBH215, PBH216, PBH217, PBH218, PBH219, PBH220, PBH221, PBH222, PBH223, PBH224, PBH225, PBH226, PBH227, PBH228, PBH229, PBH230, PBH231, PBH232, PBH233, PBH234, PBH235, PBH236, PBH237, PBH238, PBH239, PBH240, PBH241, PBH242, PBH243, PBH244, PBH245, PBH246, PBH247, PBH248, PBH249, PBH250, PBH251, PBH252, PBH253, PBH254, PBH255, PBH256, PBH257, PBH258, PBH259, PBH260, PBH261, PBH262, PBH263, PBH264, PBH265, PBH266, PBH267, PBH268, PBH269, PBH270, PBH271, PBH272, PBH273, PBH274, PBH275, PBH276, PBH277, PBH278, PBH279, PBH280, PBH281, PBH282, PBH283, PBH284, PBH285, PBH286, PBH287, PBH288, PBH289, PBH290, PBH291, PBH292, PBH293, PBH294, PBH295, PBH296, PBH297, PBH298, PBH299, PBH300, PBH301, PBH302, PBH303, PBH304, PBH305, PBH306, PBH307, PBH308, PBH309, PBH310, PBH311, PBH312, PBH313, PBH314, PBH315, PBH316, PBH317, PBH318, PBH319, PBH320, PBH321, PBH322, PBH323, PBH324, PBH325, PBH326, PBH327, PBH328, PBH329, PBH330, PBH331, PBH332, PBH333, PBH334, PBH335, PBH336, PBH337, PBH338, PBH339, PBH340, PBH341, PBH342, PBH343, PBH344, PBH345, PBH346, PBH347, PBH348, PBH349, PBH350, PBH351, PBH352, PBH353, PBH354, PBH355, PBH356, PBH357, PBH358, PBH359, PBH360, PBH361, PBH362, PBH363, PBH364, PBH365, PBH366, PBH367, PBH368, PBH369, PBH370, PBH371, PBH372, PBH373, PBH374, PBH375, PBH376, PBH377, PBH378, PBH379, PBH380, PBH381, PBH382, PBH383, PBH384, PBH385, PBH386, PBH387, PBH388, PBH389, PBH390, PBH391, PBH392, PBH393, PBH394, PBH395, PBH396, PBH397, PBH398, PBH399, PBH400, PBH401, PBH402, PBH403, PBH404, PBH405, PBH406, PBH407, PBH408, PBH409, PBH410, PBH411, PBH412, PBH413, PBH414, PBH415, PBH416, PBH417, PBH418, PBH419, PBH420, PBH421, PBH422, PBH423, PBH424, PBH425, PBH426, PBH427, PBH428, PBH429, PBH430, PBH431, PBH432, PBH433, PBH434, PBH435, PBH436, PBH437, PBH438, PBH439, PBH440, PBH441, PBH442, PBH443, PBH444, PBH445, PBH446, PBH447, PBH448, PBH449, PBH450, PBH451, PBH452, PBH453, PBH454, PBH455, PBH456, PBH457, PBH458, PBH459, PBH460, PBH461, PBH462, PBH463, PBH464, PBH465, PBH466, PBH467, PBH468, PBH469, PBH470, PBH471, PBH472, PBH473, PBH474, PBH475, PBH476, PBH477, PBH478, PBH479, PBH480, PBH481, PBH482, PBH483, PBH484, PBH485, PBH486, PBH487, PBH488, PBH489, PBH490, PBH491, PBH492, PBH493, PBH494, PBH495, PBH496, PBH497, PBH498, PBH499, PBH500, PBH501, PBH502, PBH503, PBH504, PBH505, PBH506, PBH507, PBH508, PBH509, PBH510, PBH511, PBH512, PBH513, PBH514, PBH515, PBH516, PBH517, PBH518, PBH519, PBH520, PBH521, PBH522, PBH523, PBH524, PBH525, PBH526, PBH527, PBH528, PBH529, PBH530, PBH531, PBH532, PBH533, PBH534, PBH535, PBH536, PBH537, PBH538, PBH539, PBH540, PBH541, PBH542, PBH543, PBH544, PBH545, PBH546, PBH547, PBH548, PBH549, PBH550, PBH551, PBH552, PBH553, PBH554, PBH555, PBH556, PBH557, PBH558, PBH559, PBH560, PBH561, PBH562, PBH563, PBH564, PBH565, PBH566, PBH567, PBH568, PBH569, PBH570: hole; Hole
PBIS1, PBIS2, PBIS3, PBIS4, PBIS5, PBIS6, PBIS7, PBIS8, PBIS9, PBIS10, PBIS11, PBIS12, PBIS13, PBIS14, PBIS15, PBIS16, PBIS17, PBIS18, PBIS19, PBIS20, PBIS21, PBIS22, PBIS23, PBIS24, PBIS25, PBIS26, PBIS27, PBIS28, PBIS29, PBIS30, PBIS31, PBIS32, PBIS33, PBIS34, PBIS35, PBIS36, PBIS37, PBIS38, PBIS39, PBIS40, PBIS41, PBIS42, PBIS43, PBIS44, PBIS45, PBIS46, PBIS47, PBIS48, PBIS49, PBIS50, PBIS51, PBIS52, PBIS53, PBIS54, PBIS55, PBIS56, PBIS57, PBIS58, PBIS59, PBIS60, PBIS61, PBIS62, PBIS63, PBIS64, PBIS65, PBIS66, PBIS67, PBIS68, PBIS69, PBIS70, PBIS71, PBIS72, PBIS73, PBIS74, PBIS75, PBIS76, PBIS77, PBIS78, PBIS79, PBIS80, PBIS81, PBIS82, PBIS83, PBIS84, PBIS85, PBIS86, PBIS87, PBIS88, PBIS89, PBIS90, PBIS91, PBIS92, PBIS93, PBIS94, PBIS95, PBIS96, PBIS97, PBIS98, PBIS99, PBIS100, PBIS101, PBIS102, PBIS103, PBIS104, PBIS105, PBIS106, PBIS107, PBIS108, PBIS109, PBIS110, PBIS111, PBIS112, PBIS113, PBIS114, PBIS115, PBIS116, PBIS117, PBIS118, PBIS119, PBIS120, PBIS121, PBIS122, PBIS123, PBIS124, PBIS125, PBIS126, PBIS127, PBIS128, PBIS129, PBIS130, PBIS131, PBIS132, PBIS133, PBIS134, PBIS135, PBIS136, PBIS137, PBIS138, PBIS139, PBIS140, PBIS141, PBIS142, PBIS143, PBIS144, PBIS145, PBIS146, PBIS147, PBIS148, PBIS149, PBIS150, PBIS151, PBIS152, PBIS153, PBIS154, PBIS155, PBIS156, PBIS157, PBIS158, PBIS159, PBIS160, PBIS161, PBIS162, PBIS163, PBIS164, PBIS165, PBIS166, PBIS167, PBIS168: island; Island
PBJP1, PBJP2, PBJP3, PBJP4, PBJP5, PBJP6, PBJP7, PBJP8, PBJP9, PBJP10, PBJP11, PBJP12, PBJP13, PBJP14, PBJP15, PBJP16, PBJP17, PBJP18, PBJP19, PBJP20, PBJP21, PBJP22, PBJP23, PBJP24, PBJP25, PBJP26, PBJP27, PBJP28, PBJP29, PBJP30, PBJP31, PBJP32, PBJP33, PBJP34, PBJP35, PBJP36, PBJP37, PBJP38, PBJP39, PBJP40, PBJP41, PBJP42, PBJP43, PBJP44, PBJP45, PBJP46, PBJP47, PBJP48, PBJP49, PBJP50, PBJP51, PBJP52, PBJP53, PBJP54, PBJP55, PBJP56, PBJP57, PBJP58, PBJP59, PBJP60, PBJP61, PBJP62, PBJP63, PBJP64, PBJP65, PBJP66, PBJP67, PBJP68, PBJP69, PBJP70, PBJP71, PBJP72, PBJP73, PBJP74, PBJP75, PBJP76, PBJP77, PBJP78, PBJP79, PBJP80, PBJP81, PBJP82, PBJP83, PBJP84, PBJP85, PBJP86, PBJP87, PBJP88, PBJP89, PBJP90, PBJP91, PBJP92, PBJP93, PBJP94, PBJP95, PBJP96, PBJP97, PBJP98, PBJP99, PBJP100, PBJP101, PBJP102, PBJP103, PBJP104, PBJP105, PBJP106, PBJP107, PBJP108, PBJP109, PBJP110, PBJP111, PBJP112, PBJP113, PBJP114, PBJP115, PBJP116, PBJP117, PBJP118, PBJP119, PBJP120, PBJP121, PBJP122, PBJP123, PBJP124, PBJP125, PBJP126, PBJP127, PBJP128, PBJP129, PBJP130, PBJP131, PBJP132, PBJP133, PBJP134, PBJP135, PBJP136, PBJP137, PBJP138, PBJP139, PBJP140, PBJP141, PBJP142, PBJP143, PBJP144, PBJP145, PBJP146, PBJP147, PBJP148, PBJP149, PBJP150, PBJP151, PBJP152, PBJP153, PBJP154, PBJP155, PBJP156, PBJP157, PBJP158, PBJP159, PBJP160, PBJP161, PBJP162, PBJP163, PBJP164, PBJP165, PBJP166, PBJP167, PBJP168, PBJP169, PBJP170, PBJP171, PBJP172, PBJP173, PBJP174, PBJP175, PBJP176, PBJP177, PBJP178, PBJP179, PBJP180, PBJP181, PBJP182, PBJP183, PBJP184, PBJP185, PBJP186, PBJP187, PBJP188, PBJP189, PBJP190, PBJP191, PBJP192, PBJP193, PBJP194, PBJP195, PBJP196, PBJP197, PBJP198, PBJP199, PBJP200, PBJP201, PBJP202, PBJP203, PBJP204, PBJP205, PBJP206, PBJP207, PBJP208, PBJP209, PBJP210, PBJP211, PBJP212, PBJP213, PBJP214, PBJP215, PBJP216, PBJP217, PBJP218, PBJP219, PBJP220, PBJP221, PBJP222, PBJP223, PBJP224, PBJP225, PBJP226, PBJP227, PBJP228, PBJP229, PBJP230, PBJP231, PBJP232, PBJP233, PBJP234, PBJP235, PBJP236, PBJP237, PBJP238, PBJP239, PBJP240, PBJP241, PBJP242, PBJP243, PBJP244, PBJP245, PBJP246, PBJP247, PBJP248, PBJP249, PBJP250, PBJP251, PBJP252, PBJP253, PBJP254, PBJP255, PBJP256, PBJP257, PBJP258, PBJP259, PBJP260, PBJP261, PBJP262, PBJP263, PBJP264, PBJP265, PBJP266, PBJP267, PBJP268, PBJP269, PBJP270: chevron; ChevronJumper
PBJT1, PBJT2, PBJT3, PBJT4, PBJT5, PBJT6, PBJT7, PBJT8, PBJT9, PBJT10, PBJT11, PBJT12, PBJT13, PBJT14, PBJT15, PBJT16, PBJT17, PBJT18, PBJT19, PBJT20, PBJT21, PBJT22, PBJT23, PBJT24, PBJT25, PBJT26, PBJT27, PBJT28, PBJT29, PBJT30, PBJT31, PBJT32, PBJT33, PBJT34, PBJT35, PBJT36, PBJT37, PBJT38, PBJT39, PBJT40, PBJT41, PBJT42, PBJT43, PBJT44, PBJT45, PBJT46, PBJT47, PBJT48, PBJT49, PBJT50, PBJT51, PBJT52, PBJT53, PBJT54, PBJT55, PBJT56, PBJT57, PBJT58, PBJT59, PBJT60, PBJT61, PBJT62, PBJT63, PBJT64, PBJT65, PBJT66, PBJT67, PBJT68, PBJT69, PBJT70, PBJT71, PBJT72, PBJT73, PBJT74, PBJT75, PBJT76, PBJT77, PBJT78, PBJT79, PBJT80, PBJT81, PBJT82, PBJT83, PBJT84, PBJT85, PBJT86, PBJT87, PBJT88, PBJT89, PBJT90, PBJT91, PBJT92, PBJT93, PBJT94, PBJT95, PBJT96, PBJT97, PBJT98, PBJT99, PBJT100, PBJT101, PBJT102, PBJT103, PBJT104, PBJT105, PBJT106, PBJT107, PBJT108, PBJT109, PBJT110, PBJT111, PBJT112, PBJT113, PBJT114, PBJT115, PBJT116, PBJT117, PBJT118, PBJT119, PBJT120, PBJT121, PBJT122, PBJT123, PBJT124, PBJT125, PBJT126, PBJT127, PBJT128, PBJT129, PBJT130, PBJT131, PBJT132, PBJT133, PBJT134, PBJT135, PBJT136, PBJT137, PBJT138, PBJT139, PBJT140, PBJT141, PBJT142, PBJT143, PBJT144, PBJT145, PBJT146, PBJT147, PBJT148, PBJT149, PBJT150, PBJT151, PBJT152, PBJT153, PBJT154, PBJT155, PBJT156, PBJT157, PBJT158, PBJT159, PBJT160, PBJT161, PBJT162, PBJT163, PBJT164, PBJT165, PBJT166, PBJT167, PBJT168, PBJT169, PBJT170, PBJT171, PBJT172, PBJT173, PBJT174, PBJT175, PBJT176, PBJT177, PBJT178, PBJT179, PBJT180, PBJT181, PBJT182, PBJT183, PBJT184, PBJT185, PBJT186, PBJT187, PBJT188, PBJT189, PBJT190, PBJT191, PBJT192, PBJT193, PBJT194, PBJT195, PBJT196, PBJT197, PBJT198, PBJT199, PBJT200, PBJT201, PBJT202, PBJT203, PBJT204, PBJT205, PBJT206, PBJT207, PBJT208, PBJT209, PBJT210, PBJT211, PBJT212, PBJT213, PBJT214, PBJT215, PBJT216, PBJT217, PBJT218, PBJT219, PBJT220, PBJT221, PBJT222, PBJT223, PBJT224, PBJT225, PBJT226, PBJT227, PBJT228, PBJT229, PBJT230, PBJT231, PBJT232, PBJT233, PBJT234, PBJT235, PBJT236, PBJT237, PBJT238, PBJT239, PBJT240, PBJT241, PBJT242, PBJT243, PBJT244, PBJT245, PBJT246, PBJT247, PBJT248, PBJT249, PBJT250, PBJT251, PBJT252, PBJT253, PBJT254, PBJT255, PBJT256, PBJT257, PBJT258, PBJT259, PBJT260, PBJT261, PBJT262, PBJT263, PBJT264, PBJT265, PBJT266, PBJT267, PBJT268, PBJT269, PBJT270, PBJT271, PBJT272, PBJT273, PBJT274, PBJT275, PBJT276, PBJT277, PBJT278, PBJT279, PBJT280, PBJT281, PBJT282, PBJT283, PBJT284, PBJT285, PBJT286, PBJT287, PBJT288, PBJT289, PBJT290, PBJT291, PBJT292, PBJT293, PBJT294, PBJT295, PBJT296, PBJT297, PBJT298, PBJT299, PBJT300, PBJT301, PBJT302, PBJT303, PBJT304, PBJT305, PBJT306, PBJT307, PBJT308, PBJT309, PBJT310, PBJT311, PBJT312, PBJT313, PBJT314, PBJT315, PBJT316, PBJT317, PBJT318, PBJT319, PBJT320, PBJT321, PBJT322, PBJT323, PBJT324, PBJT325, PBJT326, PBJT327, PBJT328, PBJT329, PBJT330, PBJT331, PBJT332, PBJT333, PBJT334, PBJT335, PBJT336, PBJT337, PBJT338, PBJT339, PBJT340, PBJT341, PBJT342, PBJT343, PBJT344, PBJT345, PBJT346, PBJT347, PBJT348, PBJT349, PBJT350, PBJT351, PBJT352, PBJT353, PBJT354, PBJT355, PBJT356, PBJT357, PBJT358, PBJT359, PBJT360, PBJT361, PBJT362, PBJT363, PBJT364, PBJT365, PBJT366, PBJT367, PBJT368, PBJT369, PBJT370, PBJT371, PBJT372, PBJT373, PBJT374, PBJT375, PBJT376, PBJT377, PBJT378, PBJT379, PBJT380, PBJT381, PBJT382, PBJT383, PBJT384, PBJT385, PBJT386, PBJT387, PBJT388, PBJT389, PBJT390, PBJT391, PBJT392, PBJT393, PBJT394, PBJT395, PBJT396, PBJT397, PBJT398, PBJT399, PBJT400, PBJT401, PBJT402, PBJT403, PBJT404, PBJT405, PBJT406, PBJT407, PBJT408, PBJT409, PBJT410, PBJT411, PBJT412, PBJT413, PBJT414, PBJT415, PBJT416, PBJT417, PBJT418, PBJT419, PBJT420, PBJT421, PBJT422, PBJT423, PBJT424, PBJT425, PBJT426, PBJT427, PBJT428, PBJT429, PBJT430, PBJT431, PBJT432, PBJT433, PBJT434, PBJT435, PBJT436, PBJT437, PBJT438, PBJT439, PBJT440, PBJT441, PBJT442, PBJT443, PBJT444, PBJT445, PBJT446, PBJT447, PBJT448, PBJT449, PBJT450, PBJT451, PBJT452, PBJT453, PBJT454, PBJT455, PBJT456, PBJT457, PBJT458, PBJT459, PBJT460, PBJT461, PBJT462, PBJT463, PBJT464, PBJT465, PBJT466, PBJT467, PBJT468, PBJT469, PBJT470, PBJT471, PBJT472, PBJT473, PBJT474, PBJT475, PBJT476, PBJT477, PBJT478, PBJT479, PBJT480, PBJT481, PBJT482, PBJT483, PBJT484, PBJT485, PBJT486, PBJT487, PBJT488, PBJT489, PBJT490, PBJT491, PBJT492, PBJT493, PBJT494, PBJT495, PBJT496, PBJT497, PBJT498, PBJT499, PBJT500, PBJT501, PBJT502, PBJT503, PBJT504, PBJT505, PBJT506, PBJT507, PBJT508, PBJT509, PBJT510, PBJT511, PBJT512, PBJT513, PBJT514, PBJT515, PBJT516, PBJT517, PBJT518, PBJT519, PBJT520, PBJT521, PBJT522, PBJT523, PBJT524, PBJT525, PBJT526, PBJT527, PBJT528, PBJT529, PBJT530, PBJT531, PBJT532, PBJT533, PBJT534, PBJT535, PBJT536, PBJT537, PBJT538, PBJT539, PBJT540, PBJT541, PBJT542, PBJT543, PBJT544, PBJT545, PBJT546, PBJT547, PBJT548, PBJT549, PBJT550, PBJT551, PBJT552, PBJT553, PBJT554, PBJT555, PBJT556, PBJT557, PBJT558, PBJT559, PBJT560, PBJT561, PBJT562, PBJT563, PBJT564, PBJT565, PBJT566, PBJT567, PBJT568, PBJT569, PBJT570, PBJT571, PBJT572, PBJT573, PBJT574, PBJT575, PBJT576, PBJT577, PBJT578, PBJT579, PBJT580, PBJT581, PBJT582, PBJT583, PBJT584, PBJT585, PBJT586, PBJT587, PBJT588, PBJT589, PBJT590, PBJT591, PBJT592, PBJT593, PBJT594, PBJT595, PBJT596, PBJT597, PBJT598, PBJT599, PBJT600, PBJT601, PBJT602, PBJT603, PBJT604, PBJT605, PBJT606, PBJT607, PBJT608, PBJT609, PBJT610, PBJT611, PBJT612, PBJT613, PBJT614, PBJT615, PBJT616, PBJT617, PBJT618, PBJT619, PBJT620, PBJT621, PBJT622, PBJT623, PBJT624, PBJT625, PBJT626, PBJT627, PBJT628, PBJT629, PBJT630, PBJT631, PBJT632, PBJT633, PBJT634, PBJT635, PBJT636, PBJT637, PBJT638, PBJT639, PBJT640, PBJT641, PBJT642, PBJT643, PBJT644, PBJT645, PBJT646, PBJT647, PBJT648, PBJT649, PBJT650, PBJT651, PBJT652, PBJT653, PBJT654, PBJT655, PBJT656, PBJT657, PBJT658, PBJT659, PBJT660, PBJT661, PBJT662, PBJT663, PBJT664, PBJT665, PBJT666, PBJT667, PBJT668, PBJT669, PBJT670, PBJT671, PBJT672, PBJT673, PBJT674, PBJT675, PBJT676, PBJT677, PBJT678, PBJT679, PBJT680, PBJT681, PBJT682, PBJT683, PBJT684, PBJT685, PBJT686, PBJT687, PBJT688, PBJT689, PBJT690, PBJT691, PBJT692, PBJT693, PBJT694, PBJT695, PBJT696, PBJT697, PBJT698, PBJT699, PBJT700, PBJT701, PBJT702, PBJT703, PBJT704, PBJT705: chevron; ChevronJumper
PBMH1, PBMH2, PBMH3, PBMH4: mounting hole; MountingHole

Connections:
BUS_R1: PBH1.1, PBH20.1, PBH39.1, PBH58.1, PBH77.1, PBH96.1, PBH115.1, PBH134.1, PBH153.1, PBH172.1, PBH191.1, PBH210.1, PBH229.1, PBH248.1, PBH267.1, PBH286.1, PBH305.1, PBH324.1, PBH343.1, PBH362.1, PBH381.1, PBH400.1, PBH419.1, PBH438.1, PBH457.1, PBH476.1, PBH495.1, PBH514.1, PBH533.1, PBH552.1, PBJP1.1, PBJP10.1, PBJP19.1, PBJP28.1, PBJP37.1, PBJP46.1, PBJP55.1, PBJP64.1, PBJP73.1, PBJP82.1, PBJP91.1, PBJP100.1, PBJP109.1, PBJP118.1, PBJP127.1, PBJP136.1, PBJP145.1, PBJP154.1, PBJP163.1, PBJP172.1, PBJP181.1, PBJP190.1, PBJP199.1, PBJP208.1, PBJP217.1, PBJP226.1, PBJP235.1, PBJP244.1, PBJP253.1, PBJP262.1, PBJT436.2, PBJT445.1, PBJT454.2, PBJT463.1, PBJT472.2, PBJT481.1, PBJT490.2, PBJT499.1, PBJT508.2, PBJT517.1, PBJT526.2, PBJT535.1, PBJT544.2, PBJT553.1, PBJT562.2, PBJT571.1, PBJT580.2, PBJT589.1, PBJT598.2, PBJT607.1, PBJT616.2, PBJT625.1, PBJT634.2, PBJT643.1, PBJT652.2, PBJT661.1, PBJT670.2, PBJT679.1, PBJT688.2, PBJT697.1
BUS_R7: PBH7.1, PBH26.1, PBH45.1, PBH64.1, PBH83.1, PBH102.1, PBH121.1, PBH140.1, PBH159.1, PBH178.1, PBH197.1, PBH216.1, PBH235.1, PBH254.1, PBH273.1, PBH292.1, PBH311.1, PBH330.1, PBH349.1, PBH368.1, PBH387.1, PBH406.1, PBH425.1, PBH444.1, PBH463.1, PBH482.1, PBH501.1, PBH520.1, PBH539.1, PBH558.1, PBJP3.2, PBJP4.1, PBJP12.2, PBJP13.1, PBJP21.2, PBJP22.1, PBJP30.2, PBJP31.1, PBJP39.2, PBJP40.1, PBJP48.2, PBJP49.1, PBJP57.2, PBJP58.1, PBJP66.2, PBJP67.1, PBJP75.2, PBJP76.1, PBJP84.2, PBJP85.1, PBJP93.2, PBJP94.1, PBJP102.2, PBJP103.1, PBJP111.2, PBJP112.1, PBJP120.2, PBJP121.1, PBJP129.2, PBJP130.1, PBJP138.2, PBJP139.1, PBJP147.2, PBJP148.1, PBJP156.2, PBJP157.1, PBJP165.2, PBJP166.1, PBJP174.2, PBJP175.1, PBJP183.2, PBJP184.1, PBJP192.2, PBJP193.1, PBJP201.2, PBJP202.1, PBJP210.2, PBJP211.1, PBJP219.2, PBJP220.1, PBJP228.2, PBJP229.1, PBJP237.2, PBJP238.1, PBJP246.2, PBJP247.1, PBJP255.2, PBJP256.1, PBJP264.2, PBJP265.1, PBJT438.1, PBJT439.2, PBJT447.2, PBJT448.1, PBJT456.1, PBJT457.2, PBJT465.2, PBJT466.1, PBJT474.1, PBJT475.2, PBJT483.2, PBJT484.1, PBJT492.1, PBJT493.2, PBJT501.2, PBJT502.1, PBJT510.1, PBJT511.2, PBJT519.2, PBJT520.1, PBJT528.1, PBJT529.2, PBJT537.2, PBJT538.1, PBJT546.1, PBJT547.2, PBJT555.2, PBJT556.1, PBJT564.1, PBJT565.2, PBJT573.2, PBJT574.1, PBJT582.1, PBJT583.2, PBJT591.2, PBJT592.1, PBJT600.1, PBJT601.2, PBJT609.2, PBJT610.1, PBJT618.1, PBJT619.2, PBJT627.2, PBJT628.1, PBJT636.1, PBJT637.2, PBJT645.2, PBJT646.1, PBJT654.1, PBJT655.2, PBJT663.2, PBJT664.1, PBJT672.1, PBJT673.2, PBJT681.2, PBJT682.1, PBJT690.1, PBJT691.2, PBJT699.2, PBJT700.1
BUS_R13: PBH13.1, PBH32.1, PBH51.1, PBH70.1, PBH89.1, PBH108.1, PBH127.1, PBH146.1, PBH165.1, PBH184.1, PBH203.1, PBH222.1, PBH241.1, PBH260.1, PBH279.1, PBH298.1, PBH317.1, PBH336.1, PBH355.1, PBH374.1, PBH393.1, PBH412.1, PBH431.1, PBH450.1, PBH469.1, PBH488.1, PBH507.1, PBH526.1, PBH545.1, PBH564.1, PBJP6.2, PBJP7.1, PBJP15.2, PBJP16.1, PBJP24.2, PBJP25.1, PBJP33.2, PBJP34.1, PBJP42.2, PBJP43.1, PBJP51.2, PBJP52.1, PBJP60.2, PBJP61.1, PBJP69.2, PBJP70.1, PBJP78.2, PBJP79.1, PBJP87.2, PBJP88.1, PBJP96.2, PBJP97.1, PBJP105.2, PBJP106.1, PBJP114.2, PBJP115.1, PBJP123.2, PBJP124.1, PBJP132.2, PBJP133.1, PBJP141.2, PBJP142.1, PBJP150.2, PBJP151.1, PBJP159.2, PBJP160.1, PBJP168.2, PBJP169.1, PBJP177.2, PBJP178.1, PBJP186.2, PBJP187.1, PBJP195.2, PBJP196.1, PBJP204.2, PBJP205.1, PBJP213.2, PBJP214.1, PBJP222.2, PBJP223.1, PBJP231.2, PBJP232.1, PBJP240.2, PBJP241.1, PBJP249.2, PBJP250.1, PBJP258.2, PBJP259.1, PBJP267.2, PBJP268.1, PBJT441.1, PBJT442.2, PBJT450.2, PBJT451.1, PBJT459.1, PBJT460.2, PBJT468.2, PBJT469.1, PBJT477.1, PBJT478.2, PBJT486.2, PBJT487.1, PBJT495.1, PBJT496.2, PBJT504.2, PBJT505.1, PBJT513.1, PBJT514.2, PBJT522.2, PBJT523.1, PBJT531.1, PBJT532.2, PBJT540.2, PBJT541.1, PBJT549.1, PBJT550.2, PBJT558.2, PBJT559.1, PBJT567.1, PBJT568.2, PBJT576.2, PBJT577.1, PBJT585.1, PBJT586.2, PBJT594.2, PBJT595.1, PBJT603.1, PBJT604.2, PBJT612.2, PBJT613.1, PBJT621.1, PBJT622.2, PBJT630.2, PBJT631.1, PBJT639.1, PBJT640.2, PBJT648.2, PBJT649.1, PBJT657.1, PBJT658.2, PBJT666.2, PBJT667.1, PBJT675.1, PBJT676.2, PBJT684.2, PBJT685.1, PBJT693.1, PBJT694.2, PBJT702.2, PBJT703.1
BUS_R19: PBH19.1, PBH38.1, PBH57.1, PBH76.1, PBH95.1, PBH114.1, PBH133.1, PBH152.1, PBH171.1, PBH190.1, PBH209.1, PBH228.1, PBH247.1, PBH266.1, PBH285.1, PBH304.1, PBH323.1, PBH342.1, PBH361.1, PBH380.1, PBH399.1, PBH418.1, PBH437.1, PBH456.1, PBH475.1, PBH494.1, PBH513.1, PBH532.1, PBH551.1, PBH570.1, PBJP9.2, PBJP18.2, PBJP27.2, PBJP36.2, PBJP45.2, PBJP54.2, PBJP63.2, PBJP72.2, PBJP81.2, PBJP90.2, PBJP99.2, PBJP108.2, PBJP117.2, PBJP126.2, PBJP135.2, PBJP144.2, PBJP153.2, PBJP162.2, PBJP171.2, PBJP180.2, PBJP189.2, PBJP198.2, PBJP207.2, PBJP216.2, PBJP225.2, PBJP234.2, PBJP243.2, PBJP252.2, PBJP261.2, PBJP270.2, PBJT444.1, PBJT453.2, PBJT462.1, PBJT471.2, PBJT480.1, PBJT489.2, PBJT498.1, PBJT507.2, PBJT516.1, PBJT525.2, PBJT534.1, PBJT543.2, PBJT552.1, PBJT561.2, PBJT570.1, PBJT579.2, PBJT588.1, PBJT597.2, PBJT606.1, PBJT615.2, PBJT624.1, PBJT633.2, PBJT642.1, PBJT651.2, PBJT660.1, PBJT669.2, PBJT678.1, PBJT687.2, PBJT696.1, PBJT705.2
C1_R2: PBH2.1, PBH3.1, PBIS1.1, PBJP1.2, PBJP2.1, PBJT1.2, PBJT30.1, PBJT436.1, PBJT437.2
C1_R4: PBH4.1, PBH5.1, PBH6.1, PBIS29.1, PBJP2.2, PBJP3.1, PBJT59.2, PBJT88.1, PBJT117.2, PBJT437.1, PBJT438.2
C1_R8: PBH8.1, PBH9.1, PBIS57.1, PBJP4.2, PBJP5.1, PBJT146.2, PBJT175.1, PBJT439.1, PBJT440.2
C1_R10: PBH10.1, PBH11.1, PBH12.1, PBIS85.1, PBJP5.2, PBJP6.1, PBJT204.2, PBJT233.1, PBJT262.2, PBJT440.1, PBJT441.2
C1_R14: PBH14.1, PBH15.1, PBIS113.1, PBJP7.2, PBJP8.1, PBJT291.2, PBJT320.1, PBJT442.1, PBJT443.2
C1_R16: PBH16.1, PBH17.1, PBH18.1, PBIS141.1, PBJP8.2, PBJP9.1, PBJT349.2, PBJT378.1, PBJT407.2, PBJT443.1, PBJT444.2
C2_R2: PBH21.1, PBH22.1, PBJP10.2, PBJP11.1, PBJT1.1, PBJT2.2, PBJT30.2, PBJT31.1, PBJT445.2, PBJT446.1
C2_R4: PBH23.1, PBH24.1, PBH25.1, PBJP11.2, PBJP12.1, PBJT59.1, PBJT60.2, PBJT88.2, PBJT89.1, PBJT117.1, PBJT118.2, PBJT446.2, PBJT447.1
C2_R8: PBH27.1, PBH28.1, PBJP13.2, PBJP14.1, PBJT146.1, PBJT147.2, PBJT175.2, PBJT176.1, PBJT448.2, PBJT449.1
C2_R10: PBH29.1, PBH30.1, PBH31.1, PBJP14.2, PBJP15.1, PBJT204.1, PBJT205.2, PBJT233.2, PBJT234.1, PBJT262.1, PBJT263.2, PBJT449.2, PBJT450.1
C2_R14: PBH33.1, PBH34.1, PBJP16.2, PBJP17.1, PBJT291.1, PBJT292.2, PBJT320.2, PBJT321.1, PBJT451.2, PBJT452.1
C2_R16: PBH35.1, PBH36.1, PBH37.1, PBJP17.2, PBJP18.1, PBJT349.1, PBJT350.2, PBJT378.2, PBJT379.1, PBJT407.1, PBJT408.2, PBJT452.2, PBJT453.1
C3_R2: PBH40.1, PBH41.1, PBIS2.1, PBIS3.1, PBJP19.2, PBJP20.1, PBJT2.1, PBJT3.2, PBJT31.2, PBJT32.1, PBJT454.1, PBJT455.2
C3_R4: PBH42.1, PBH43.1, PBH44.1, PBIS30.1, PBIS31.1, PBJP20.2, PBJP21.1, PBJT60.1, PBJT61.2, PBJT89.2, PBJT90.1, PBJT118.1, PBJT119.2, PBJT455.1, PBJT456.2
C3_R8: PBH46.1, PBH47.1, PBIS58.1, PBIS59.1, PBJP22.2, PBJP23.1, PBJT147.1, PBJT148.2, PBJT176.2, PBJT177.1, PBJT457.1, PBJT458.2
C3_R10: PBH48.1, PBH49.1, PBH50.1, PBIS86.1, PBIS87.1, PBJP23.2, PBJP24.1, PBJT205.1, PBJT206.2, PBJT234.2, PBJT235.1, PBJT263.1, PBJT264.2, PBJT458.1, PBJT459.2
C3_R14: PBH52.1, PBH53.1, PBIS114.1, PBIS115.1, PBJP25.2, PBJP26.1, PBJT292.1, PBJT293.2, PBJT321.2, PBJT322.1, PBJT460.1, PBJT461.2
C3_R16: PBH54.1, PBH55.1, PBH56.1, PBIS142.1, PBIS143.1, PBJP26.2, PBJP27.1, PBJT350.1, PBJT351.2, PBJT379.2, PBJT380.1, PBJT408.1, PBJT409.2, PBJT461.1, PBJT462.2
C4_R2: PBH59.1, PBH60.1, PBJP28.2, PBJP29.1, PBJT3.1, PBJT4.2, PBJT32.2, PBJT33.1, PBJT463.2, PBJT464.1
C4_R4: PBH61.1, PBH62.1, PBH63.1, PBJP29.2, PBJP30.1, PBJT61.1, PBJT62.2, PBJT90.2, PBJT91.1, PBJT119.1, PBJT120.2, PBJT464.2, PBJT465.1
C4_R8: PBH65.1, PBH66.1, PBJP31.2, PBJP32.1, PBJT148.1, PBJT149.2, PBJT177.2, PBJT178.1, PBJT466.2, PBJT467.1
C4_R10: PBH67.1, PBH68.1, PBH69.1, PBJP32.2, PBJP33.1, PBJT206.1, PBJT207.2, PBJT235.2, PBJT236.1, PBJT264.1, PBJT265.2, PBJT467.2, PBJT468.1
C4_R14: PBH71.1, PBH72.1, PBJP34.2, PBJP35.1, PBJT293.1, PBJT294.2, PBJT322.2, PBJT323.1, PBJT469.2, PBJT470.1
C4_R16: PBH73.1, PBH74.1, PBH75.1, PBJP35.2, PBJP36.1, PBJT351.1, PBJT352.2, PBJT380.2, PBJT381.1, PBJT409.1, PBJT410.2, PBJT470.2, PBJT471.1
C5_R2: PBH78.1, PBH79.1, PBIS4.1, PBIS5.1, PBJP37.2, PBJP38.1, PBJT4.1, PBJT5.2, PBJT33.2, PBJT34.1, PBJT472.1, PBJT473.2
C5_R4: PBH80.1, PBH81.1, PBH82.1, PBIS32.1, PBIS33.1, PBJP38.2, PBJP39.1, PBJT62.1, PBJT63.2, PBJT91.2, PBJT92.1, PBJT120.1, PBJT121.2, PBJT473.1, PBJT474.2
C5_R8: PBH84.1, PBH85.1, PBIS60.1, PBIS61.1, PBJP40.2, PBJP41.1, PBJT149.1, PBJT150.2, PBJT178.2, PBJT179.1, PBJT475.1, PBJT476.2
C5_R10: PBH86.1, PBH87.1, PBH88.1, PBIS88.1, PBIS89.1, PBJP41.2, PBJP42.1, PBJT207.1, PBJT208.2, PBJT236.2, PBJT237.1, PBJT265.1, PBJT266.2, PBJT476.1, PBJT477.2
C5_R14: PBH90.1, PBH91.1, PBIS116.1, PBIS117.1, PBJP43.2, PBJP44.1, PBJT294.1, PBJT295.2, PBJT323.2, PBJT324.1, PBJT478.1, PBJT479.2
C5_R16: PBH92.1, PBH93.1, PBH94.1, PBIS144.1, PBIS145.1, PBJP44.2, PBJP45.1, PBJT352.1, PBJT353.2, PBJT381.2, PBJT382.1, PBJT410.1, PBJT411.2, PBJT479.1, PBJT480.2
C6_R2: PBH97.1, PBH98.1, PBJP46.2, PBJP47.1, PBJT5.1, PBJT6.2, PBJT34.2, PBJT35.1, PBJT481.2, PBJT482.1
C6_R4: PBH99.1, PBH100.1, PBH101.1, PBJP47.2, PBJP48.1, PBJT63.1, PBJT64.2, PBJT92.2, PBJT93.1, PBJT121.1, PBJT122.2, PBJT482.2, PBJT483.1
C6_R8: PBH103.1, PBH104.1, PBJP49.2, PBJP50.1, PBJT150.1, PBJT151.2, PBJT179.2, PBJT180.1, PBJT484.2, PBJT485.1
C6_R10: PBH105.1, PBH106.1, PBH107.1, PBJP50.2, PBJP51.1, PBJT208.1, PBJT209.2, PBJT237.2, PBJT238.1, PBJT266.1, PBJT267.2, PBJT485.2, PBJT486.1
C6_R14: PBH109.1, PBH110.1, PBJP52.2, PBJP53.1, PBJT295.1, PBJT296.2, PBJT324.2, PBJT325.1, PBJT487.2, PBJT488.1
C6_R16: PBH111.1, PBH112.1, PBH113.1, PBJP53.2, PBJP54.1, PBJT353.1, PBJT354.2, PBJT382.2, PBJT383.1, PBJT411.1, PBJT412.2, PBJT488.2, PBJT489.1
C7_R2: PBH116.1, PBH117.1, PBIS6.1, PBIS7.1, PBJP55.2, PBJP56.1, PBJT6.1, PBJT7.2, PBJT35.2, PBJT36.1, PBJT490.1, PBJT491.2
C7_R4: PBH118.1, PBH119.1, PBH120.1, PBIS34.1, PBIS35.1, PBJP56.2, PBJP57.1, PBJT64.1, PBJT65.2, PBJT93.2, PBJT94.1, PBJT122.1, PBJT123.2, PBJT491.1, PBJT492.2
C7_R8: PBH122.1, PBH123.1, PBIS62.1, PBIS63.1, PBJP58.2, PBJP59.1, PBJT151.1, PBJT152.2, PBJT180.2, PBJT181.1, PBJT493.1, PBJT494.2
C7_R10: PBH124.1, PBH125.1, PBH126.1, PBIS90.1, PBIS91.1, PBJP59.2, PBJP60.1, PBJT209.1, PBJT210.2, PBJT238.2, PBJT239.1, PBJT267.1, PBJT268.2, PBJT494.1, PBJT495.2
C7_R14: PBH128.1, PBH129.1, PBIS118.1, PBIS119.1, PBJP61.2, PBJP62.1, PBJT296.1, PBJT297.2, PBJT325.2, PBJT326.1, PBJT496.1, PBJT497.2
C7_R16: PBH130.1, PBH131.1, PBH132.1, PBIS146.1, PBIS147.1, PBJP62.2, PBJP63.1, PBJT354.1, PBJT355.2, PBJT383.2, PBJT384.1, PBJT412.1, PBJT413.2, PBJT497.1, PBJT498.2
C8_R2: PBH135.1, PBH136.1, PBJP64.2, PBJP65.1, PBJT7.1, PBJT8.2, PBJT36.2, PBJT37.1, PBJT499.2, PBJT500.1
C8_R4: PBH137.1, PBH138.1, PBH139.1, PBJP65.2, PBJP66.1, PBJT65.1, PBJT66.2, PBJT94.2, PBJT95.1, PBJT123.1, PBJT124.2, PBJT500.2, PBJT501.1
C8_R8: PBH141.1, PBH142.1, PBJP67.2, PBJP68.1, PBJT152.1, PBJT153.2, PBJT181.2, PBJT182.1, PBJT502.2, PBJT503.1
C8_R10: PBH143.1, PBH144.1, PBH145.1, PBJP68.2, PBJP69.1, PBJT210.1, PBJT211.2, PBJT239.2, PBJT240.1, PBJT268.1, PBJT269.2, PBJT503.2, PBJT504.1
C8_R14: PBH147.1, PBH148.1, PBJP70.2, PBJP71.1, PBJT297.1, PBJT298.2, PBJT326.2, PBJT327.1, PBJT505.2, PBJT506.1
C8_R16: PBH149.1, PBH150.1, PBH151.1, PBJP71.2, PBJP72.1, PBJT355.1, PBJT356.2, PBJT384.2, PBJT385.1, PBJT413.1, PBJT414.2, PBJT506.2, PBJT507.1
C9_R2: PBH154.1, PBH155.1, PBIS8.1, PBIS9.1, PBJP73.2, PBJP74.1, PBJT8.1, PBJT9.2, PBJT37.2, PBJT38.1, PBJT508.1, PBJT509.2
C9_R4: PBH156.1, PBH157.1, PBH158.1, PBIS36.1, PBIS37.1, PBJP74.2, PBJP75.1, PBJT66.1, PBJT67.2, PBJT95.2, PBJT96.1, PBJT124.1, PBJT125.2, PBJT509.1, PBJT510.2
C9_R8: PBH160.1, PBH161.1, PBIS64.1, PBIS65.1, PBJP76.2, PBJP77.1, PBJT153.1, PBJT154.2, PBJT182.2, PBJT183.1, PBJT511.1, PBJT512.2
C9_R10: PBH162.1, PBH163.1, PBH164.1, PBIS92.1, PBIS93.1, PBJP77.2, PBJP78.1, PBJT211.1, PBJT212.2, PBJT240.2, PBJT241.1, PBJT269.1, PBJT270.2, PBJT512.1, PBJT513.2
C9_R14: PBH166.1, PBH167.1, PBIS120.1, PBIS121.1, PBJP79.2, PBJP80.1, PBJT298.1, PBJT299.2, PBJT327.2, PBJT328.1, PBJT514.1, PBJT515.2
C9_R16: PBH168.1, PBH169.1, PBH170.1, PBIS148.1, PBIS149.1, PBJP80.2, PBJP81.1, PBJT356.1, PBJT357.2, PBJT385.2, PBJT386.1, PBJT414.1, PBJT415.2, PBJT515.1, PBJT516.2
C10_R2: PBH173.1, PBH174.1, PBJP82.2, PBJP83.1, PBJT9.1, PBJT10.2, PBJT38.2, PBJT39.1, PBJT517.2, PBJT518.1
C10_R4: PBH175.1, PBH176.1, PBH177.1, PBJP83.2, PBJP84.1, PBJT67.1, PBJT68.2, PBJT96.2, PBJT97.1, PBJT125.1, PBJT126.2, PBJT518.2, PBJT519.1
C10_R8: PBH179.1, PBH180.1, PBJP85.2, PBJP86.1, PBJT154.1, PBJT155.2, PBJT183.2, PBJT184.1, PBJT520.2, PBJT521.1
C10_R10: PBH181.1, PBH182.1, PBH183.1, PBJP86.2, PBJP87.1, PBJT212.1, PBJT213.2, PBJT241.2, PBJT242.1, PBJT270.1, PBJT271.2, PBJT521.2, PBJT522.1
C10_R14: PBH185.1, PBH186.1, PBJP88.2, PBJP89.1, PBJT299.1, PBJT300.2, PBJT328.2, PBJT329.1, PBJT523.2, PBJT524.1
C10_R16: PBH187.1, PBH188.1, PBH189.1, PBJP89.2, PBJP90.1, PBJT357.1, PBJT358.2, PBJT386.2, PBJT387.1, PBJT415.1, PBJT416.2, PBJT524.2, PBJT525.1
C11_R2: PBH192.1, PBH193.1, PBIS10.1, PBIS11.1, PBJP91.2, PBJP92.1, PBJT10.1, PBJT11.2, PBJT39.2, PBJT40.1, PBJT526.1, PBJT527.2
C11_R4: PBH194.1, PBH195.1, PBH196.1, PBIS38.1, PBIS39.1, PBJP92.2, PBJP93.1, PBJT68.1, PBJT69.2, PBJT97.2, PBJT98.1, PBJT126.1, PBJT127.2, PBJT527.1, PBJT528.2
C11_R8: PBH198.1, PBH199.1, PBIS66.1, PBIS67.1, PBJP94.2, PBJP95.1, PBJT155.1, PBJT156.2, PBJT184.2, PBJT185.1, PBJT529.1, PBJT530.2
C11_R10: PBH200.1, PBH201.1, PBH202.1, PBIS94.1, PBIS95.1, PBJP95.2, PBJP96.1, PBJT213.1, PBJT214.2, PBJT242.2, PBJT243.1, PBJT271.1, PBJT272.2, PBJT530.1, PBJT531.2
C11_R14: PBH204.1, PBH205.1, PBIS122.1, PBIS123.1, PBJP97.2, PBJP98.1, PBJT300.1, PBJT301.2, PBJT329.2, PBJT330.1, PBJT532.1, PBJT533.2
C11_R16: PBH206.1, PBH207.1, PBH208.1, PBIS150.1, PBIS151.1, PBJP98.2, PBJP99.1, PBJT358.1, PBJT359.2, PBJT387.2, PBJT388.1, PBJT416.1, PBJT417.2, PBJT533.1, PBJT534.2
C12_R2: PBH211.1, PBH212.1, PBJP100.2, PBJP101.1, PBJT11.1, PBJT12.2, PBJT40.2, PBJT41.1, PBJT535.2, PBJT536.1
C12_R4: PBH213.1, PBH214.1, PBH215.1, PBJP101.2, PBJP102.1, PBJT69.1, PBJT70.2, PBJT98.2, PBJT99.1, PBJT127.1, PBJT128.2, PBJT536.2, PBJT537.1
C12_R8: PBH217.1, PBH218.1, PBJP103.2, PBJP104.1, PBJT156.1, PBJT157.2, PBJT185.2, PBJT186.1, PBJT538.2, PBJT539.1
C12_R10: PBH219.1, PBH220.1, PBH221.1, PBJP104.2, PBJP105.1, PBJT214.1, PBJT215.2, PBJT243.2, PBJT244.1, PBJT272.1, PBJT273.2, PBJT539.2, PBJT540.1
C12_R14: PBH223.1, PBH224.1, PBJP106.2, PBJP107.1, PBJT301.1, PBJT302.2, PBJT330.2, PBJT331.1, PBJT541.2, PBJT542.1
C12_R16: PBH225.1, PBH226.1, PBH227.1, PBJP107.2, PBJP108.1, PBJT359.1, PBJT360.2, PBJT388.2, PBJT389.1, PBJT417.1, PBJT418.2, PBJT542.2, PBJT543.1
C13_R2: PBH230.1, PBH231.1, PBIS12.1, PBIS13.1, PBJP109.2, PBJP110.1, PBJT12.1, PBJT13.2, PBJT41.2, PBJT42.1, PBJT544.1, PBJT545.2
C13_R4: PBH232.1, PBH233.1, PBH234.1, PBIS40.1, PBIS41.1, PBJP110.2, PBJP111.1, PBJT70.1, PBJT71.2, PBJT99.2, PBJT100.1, PBJT128.1, PBJT129.2, PBJT545.1, PBJT546.2
C13_R8: PBH236.1, PBH237.1, PBIS68.1, PBIS69.1, PBJP112.2, PBJP113.1, PBJT157.1, PBJT158.2, PBJT186.2, PBJT187.1, PBJT547.1, PBJT548.2
C13_R10: PBH238.1, PBH239.1, PBH240.1, PBIS96.1, PBIS97.1, PBJP113.2, PBJP114.1, PBJT215.1, PBJT216.2, PBJT244.2, PBJT245.1, PBJT273.1, PBJT274.2, PBJT548.1, PBJT549.2
C13_R14: PBH242.1, PBH243.1, PBIS124.1, PBIS125.1, PBJP115.2, PBJP116.1, PBJT302.1, PBJT303.2, PBJT331.2, PBJT332.1, PBJT550.1, PBJT551.2
C13_R16: PBH244.1, PBH245.1, PBH246.1, PBIS152.1, PBIS153.1, PBJP116.2, PBJP117.1, PBJT360.1, PBJT361.2, PBJT389.2, PBJT390.1, PBJT418.1, PBJT419.2, PBJT551.1, PBJT552.2
C14_R2: PBH249.1, PBH250.1, PBJP118.2, PBJP119.1, PBJT13.1, PBJT14.2, PBJT42.2, PBJT43.1, PBJT553.2, PBJT554.1
C14_R4: PBH251.1, PBH252.1, PBH253.1, PBJP119.2, PBJP120.1, PBJT71.1, PBJT72.2, PBJT100.2, PBJT101.1, PBJT129.1, PBJT130.2, PBJT554.2, PBJT555.1
C14_R8: PBH255.1, PBH256.1, PBJP121.2, PBJP122.1, PBJT158.1, PBJT159.2, PBJT187.2, PBJT188.1, PBJT556.2, PBJT557.1
C14_R10: PBH257.1, PBH258.1, PBH259.1, PBJP122.2, PBJP123.1, PBJT216.1, PBJT217.2, PBJT245.2, PBJT246.1, PBJT274.1, PBJT275.2, PBJT557.2, PBJT558.1
C14_R14: PBH261.1, PBH262.1, PBJP124.2, PBJP125.1, PBJT303.1, PBJT304.2, PBJT332.2, PBJT333.1, PBJT559.2, PBJT560.1
C14_R16: PBH263.1, PBH264.1, PBH265.1, PBJP125.2, PBJP126.1, PBJT361.1, PBJT362.2, PBJT390.2, PBJT391.1, PBJT419.1, PBJT420.2, PBJT560.2, PBJT561.1
C15_R2: PBH268.1, PBH269.1, PBIS14.1, PBIS15.1, PBJP127.2, PBJP128.1, PBJT14.1, PBJT15.2, PBJT43.2, PBJT44.1, PBJT562.1, PBJT563.2
C15_R4: PBH270.1, PBH271.1, PBH272.1, PBIS42.1, PBIS43.1, PBJP128.2, PBJP129.1, PBJT72.1, PBJT73.2, PBJT101.2, PBJT102.1, PBJT130.1, PBJT131.2, PBJT563.1, PBJT564.2
C15_R8: PBH274.1, PBH275.1, PBIS70.1, PBIS71.1, PBJP130.2, PBJP131.1, PBJT159.1, PBJT160.2, PBJT188.2, PBJT189.1, PBJT565.1, PBJT566.2
C15_R10: PBH276.1, PBH277.1, PBH278.1, PBIS98.1, PBIS99.1, PBJP131.2, PBJP132.1, PBJT217.1, PBJT218.2, PBJT246.2, PBJT247.1, PBJT275.1, PBJT276.2, PBJT566.1, PBJT567.2
C15_R14: PBH280.1, PBH281.1, PBIS126.1, PBIS127.1, PBJP133.2, PBJP134.1, PBJT304.1, PBJT305.2, PBJT333.2, PBJT334.1, PBJT568.1, PBJT569.2
C15_R16: PBH282.1, PBH283.1, PBH284.1, PBIS154.1, PBIS155.1, PBJP134.2, PBJP135.1, PBJT362.1, PBJT363.2, PBJT391.2, PBJT392.1, PBJT420.1, PBJT421.2, PBJT569.1, PBJT570.2
C16_R2: PBH287.1, PBH288.1, PBJP136.2, PBJP137.1, PBJT15.1, PBJT16.2, PBJT44.2, PBJT45.1, PBJT571.2, PBJT572.1
C16_R4: PBH289.1, PBH290.1, PBH291.1, PBJP137.2, PBJP138.1, PBJT73.1, PBJT74.2, PBJT102.2, PBJT103.1, PBJT131.1, PBJT132.2, PBJT572.2, PBJT573.1
C16_R8: PBH293.1, PBH294.1, PBJP139.2, PBJP140.1, PBJT160.1, PBJT161.2, PBJT189.2, PBJT190.1, PBJT574.2, PBJT575.1
C16_R10: PBH295.1, PBH296.1, PBH297.1, PBJP140.2, PBJP141.1, PBJT218.1, PBJT219.2, PBJT247.2, PBJT248.1, PBJT276.1, PBJT277.2, PBJT575.2, PBJT576.1
C16_R14: PBH299.1, PBH300.1, PBJP142.2, PBJP143.1, PBJT305.1, PBJT306.2, PBJT334.2, PBJT335.1, PBJT577.2, PBJT578.1
C16_R16: PBH301.1, PBH302.1, PBH303.1, PBJP143.2, PBJP144.1, PBJT363.1, PBJT364.2, PBJT392.2, PBJT393.1, PBJT421.1, PBJT422.2, PBJT578.2, PBJT579.1
C17_R2: PBH306.1, PBH307.1, PBIS16.1, PBIS17.1, PBJP145.2, PBJP146.1, PBJT16.1, PBJT17.2, PBJT45.2, PBJT46.1, PBJT580.1, PBJT581.2
C17_R4: PBH308.1, PBH309.1, PBH310.1, PBIS44.1, PBIS45.1, PBJP146.2, PBJP147.1, PBJT74.1, PBJT75.2, PBJT103.2, PBJT104.1, PBJT132.1, PBJT133.2, PBJT581.1, PBJT582.2
C17_R8: PBH312.1, PBH313.1, PBIS72.1, PBIS73.1, PBJP148.2, PBJP149.1, PBJT161.1, PBJT162.2, PBJT190.2, PBJT191.1, PBJT583.1, PBJT584.2
C17_R10: PBH314.1, PBH315.1, PBH316.1, PBIS100.1, PBIS101.1, PBJP149.2, PBJP150.1, PBJT219.1, PBJT220.2, PBJT248.2, PBJT249.1, PBJT277.1, PBJT278.2, PBJT584.1, PBJT585.2
C17_R14: PBH318.1, PBH319.1, PBIS128.1, PBIS129.1, PBJP151.2, PBJP152.1, PBJT306.1, PBJT307.2, PBJT335.2, PBJT336.1, PBJT586.1, PBJT587.2
C17_R16: PBH320.1, PBH321.1, PBH322.1, PBIS156.1, PBIS157.1, PBJP152.2, PBJP153.1, PBJT364.1, PBJT365.2, PBJT393.2, PBJT394.1, PBJT422.1, PBJT423.2, PBJT587.1, PBJT588.2
C18_R2: PBH325.1, PBH326.1, PBJP154.2, PBJP155.1, PBJT17.1, PBJT18.2, PBJT46.2, PBJT47.1, PBJT589.2, PBJT590.1
C18_R4: PBH327.1, PBH328.1, PBH329.1, PBJP155.2, PBJP156.1, PBJT75.1, PBJT76.2, PBJT104.2, PBJT105.1, PBJT133.1, PBJT134.2, PBJT590.2, PBJT591.1
C18_R8: PBH331.1, PBH332.1, PBJP157.2, PBJP158.1, PBJT162.1, PBJT163.2, PBJT191.2, PBJT192.1, PBJT592.2, PBJT593.1
C18_R10: PBH333.1, PBH334.1, PBH335.1, PBJP158.2, PBJP159.1, PBJT220.1, PBJT221.2, PBJT249.2, PBJT250.1, PBJT278.1, PBJT279.2, PBJT593.2, PBJT594.1
C18_R14: PBH337.1, PBH338.1, PBJP160.2, PBJP161.1, PBJT307.1, PBJT308.2, PBJT336.2, PBJT337.1, PBJT595.2, PBJT596.1
C18_R16: PBH339.1, PBH340.1, PBH341.1, PBJP161.2, PBJP162.1, PBJT365.1, PBJT366.2, PBJT394.2, PBJT395.1, PBJT423.1, PBJT424.2, PBJT596.2, PBJT597.1
C19_R2: PBH344.1, PBH345.1, PBIS18.1, PBIS19.1, PBJP163.2, PBJP164.1, PBJT18.1, PBJT19.2, PBJT47.2, PBJT48.1, PBJT598.1, PBJT599.2
C19_R4: PBH346.1, PBH347.1, PBH348.1, PBIS46.1, PBIS47.1, PBJP164.2, PBJP165.1, PBJT76.1, PBJT77.2, PBJT105.2, PBJT106.1, PBJT134.1, PBJT135.2, PBJT599.1, PBJT600.2
C19_R8: PBH350.1, PBH351.1, PBIS74.1, PBIS75.1, PBJP166.2, PBJP167.1, PBJT163.1, PBJT164.2, PBJT192.2, PBJT193.1, PBJT601.1, PBJT602.2
C19_R10: PBH352.1, PBH353.1, PBH354.1, PBIS102.1, PBIS103.1, PBJP167.2, PBJP168.1, PBJT221.1, PBJT222.2, PBJT250.2, PBJT251.1, PBJT279.1, PBJT280.2, PBJT602.1, PBJT603.2
C19_R14: PBH356.1, PBH357.1, PBIS130.1, PBIS131.1, PBJP169.2, PBJP170.1, PBJT308.1, PBJT309.2, PBJT337.2, PBJT338.1, PBJT604.1, PBJT605.2
C19_R16: PBH358.1, PBH359.1, PBH360.1, PBIS158.1, PBIS159.1, PBJP170.2, PBJP171.1, PBJT366.1, PBJT367.2, PBJT395.2, PBJT396.1, PBJT424.1, PBJT425.2, PBJT605.1, PBJT606.2
C20_R2: PBH363.1, PBH364.1, PBJP172.2, PBJP173.1, PBJT19.1, PBJT20.2, PBJT48.2, PBJT49.1, PBJT607.2, PBJT608.1
C20_R4: PBH365.1, PBH366.1, PBH367.1, PBJP173.2, PBJP174.1, PBJT77.1, PBJT78.2, PBJT106.2, PBJT107.1, PBJT135.1, PBJT136.2, PBJT608.2, PBJT609.1
C20_R8: PBH369.1, PBH370.1, PBJP175.2, PBJP176.1, PBJT164.1, PBJT165.2, PBJT193.2, PBJT194.1, PBJT610.2, PBJT611.1
C20_R10: PBH371.1, PBH372.1, PBH373.1, PBJP176.2, PBJP177.1, PBJT222.1, PBJT223.2, PBJT251.2, PBJT252.1, PBJT280.1, PBJT281.2, PBJT611.2, PBJT612.1
C20_R14: PBH375.1, PBH376.1, PBJP178.2, PBJP179.1, PBJT309.1, PBJT310.2, PBJT338.2, PBJT339.1, PBJT613.2, PBJT614.1
C20_R16: PBH377.1, PBH378.1, PBH379.1, PBJP179.2, PBJP180.1, PBJT367.1, PBJT368.2, PBJT396.2, PBJT397.1, PBJT425.1, PBJT426.2, PBJT614.2, PBJT615.1
C21_R2: PBH382.1, PBH383.1, PBIS20.1, PBIS21.1, PBJP181.2, PBJP182.1, PBJT20.1, PBJT21.2, PBJT49.2, PBJT50.1, PBJT616.1, PBJT617.2
C21_R4: PBH384.1, PBH385.1, PBH386.1, PBIS48.1, PBIS49.1, PBJP182.2, PBJP183.1, PBJT78.1, PBJT79.2, PBJT107.2, PBJT108.1, PBJT136.1, PBJT137.2, PBJT617.1, PBJT618.2
C21_R8: PBH388.1, PBH389.1, PBIS76.1, PBIS77.1, PBJP184.2, PBJP185.1, PBJT165.1, PBJT166.2, PBJT194.2, PBJT195.1, PBJT619.1, PBJT620.2
C21_R10: PBH390.1, PBH391.1, PBH392.1, PBIS104.1, PBIS105.1, PBJP185.2, PBJP186.1, PBJT223.1, PBJT224.2, PBJT252.2, PBJT253.1, PBJT281.1, PBJT282.2, PBJT620.1, PBJT621.2
C21_R14: PBH394.1, PBH395.1, PBIS132.1, PBIS133.1, PBJP187.2, PBJP188.1, PBJT310.1, PBJT311.2, PBJT339.2, PBJT340.1, PBJT622.1, PBJT623.2
C21_R16: PBH396.1, PBH397.1, PBH398.1, PBIS160.1, PBIS161.1, PBJP188.2, PBJP189.1, PBJT368.1, PBJT369.2, PBJT397.2, PBJT398.1, PBJT426.1, PBJT427.2, PBJT623.1, PBJT624.2
C22_R2: PBH401.1, PBH402.1, PBJP190.2, PBJP191.1, PBJT21.1, PBJT22.2, PBJT50.2, PBJT51.1, PBJT625.2, PBJT626.1
C22_R4: PBH403.1, PBH404.1, PBH405.1, PBJP191.2, PBJP192.1, PBJT79.1, PBJT80.2, PBJT108.2, PBJT109.1, PBJT137.1, PBJT138.2, PBJT626.2, PBJT627.1
C22_R8: PBH407.1, PBH408.1, PBJP193.2, PBJP194.1, PBJT166.1, PBJT167.2, PBJT195.2, PBJT196.1, PBJT628.2, PBJT629.1
C22_R10: PBH409.1, PBH410.1, PBH411.1, PBJP194.2, PBJP195.1, PBJT224.1, PBJT225.2, PBJT253.2, PBJT254.1, PBJT282.1, PBJT283.2, PBJT629.2, PBJT630.1
C22_R14: PBH413.1, PBH414.1, PBJP196.2, PBJP197.1, PBJT311.1, PBJT312.2, PBJT340.2, PBJT341.1, PBJT631.2, PBJT632.1
C22_R16: PBH415.1, PBH416.1, PBH417.1, PBJP197.2, PBJP198.1, PBJT369.1, PBJT370.2, PBJT398.2, PBJT399.1, PBJT427.1, PBJT428.2, PBJT632.2, PBJT633.1
C23_R2: PBH420.1, PBH421.1, PBIS22.1, PBIS23.1, PBJP199.2, PBJP200.1, PBJT22.1, PBJT23.2, PBJT51.2, PBJT52.1, PBJT634.1, PBJT635.2
C23_R4: PBH422.1, PBH423.1, PBH424.1, PBIS50.1, PBIS51.1, PBJP200.2, PBJP201.1, PBJT80.1, PBJT81.2, PBJT109.2, PBJT110.1, PBJT138.1, PBJT139.2, PBJT635.1, PBJT636.2
C23_R8: PBH426.1, PBH427.1, PBIS78.1, PBIS79.1, PBJP202.2, PBJP203.1, PBJT167.1, PBJT168.2, PBJT196.2, PBJT197.1, PBJT637.1, PBJT638.2
C23_R10: PBH428.1, PBH429.1, PBH430.1, PBIS106.1, PBIS107.1, PBJP203.2, PBJP204.1, PBJT225.1, PBJT226.2, PBJT254.2, PBJT255.1, PBJT283.1, PBJT284.2, PBJT638.1, PBJT639.2
C23_R14: PBH432.1, PBH433.1, PBIS134.1, PBIS135.1, PBJP205.2, PBJP206.1, PBJT312.1, PBJT313.2, PBJT341.2, PBJT342.1, PBJT640.1, PBJT641.2
C23_R16: PBH434.1, PBH435.1, PBH436.1, PBIS162.1, PBIS163.1, PBJP206.2, PBJP207.1, PBJT370.1, PBJT371.2, PBJT399.2, PBJT400.1, PBJT428.1, PBJT429.2, PBJT641.1, PBJT642.2
C24_R2: PBH439.1, PBH440.1, PBJP208.2, PBJP209.1, PBJT23.1, PBJT24.2, PBJT52.2, PBJT53.1, PBJT643.2, PBJT644.1
C24_R4: PBH441.1, PBH442.1, PBH443.1, PBJP209.2, PBJP210.1, PBJT81.1, PBJT82.2, PBJT110.2, PBJT111.1, PBJT139.1, PBJT140.2, PBJT644.2, PBJT645.1
C24_R8: PBH445.1, PBH446.1, PBJP211.2, PBJP212.1, PBJT168.1, PBJT169.2, PBJT197.2, PBJT198.1, PBJT646.2, PBJT647.1
C24_R10: PBH447.1, PBH448.1, PBH449.1, PBJP212.2, PBJP213.1, PBJT226.1, PBJT227.2, PBJT255.2, PBJT256.1, PBJT284.1, PBJT285.2, PBJT647.2, PBJT648.1
C24_R14: PBH451.1, PBH452.1, PBJP214.2, PBJP215.1, PBJT313.1, PBJT314.2, PBJT342.2, PBJT343.1, PBJT649.2, PBJT650.1
C24_R16: PBH453.1, PBH454.1, PBH455.1, PBJP215.2, PBJP216.1, PBJT371.1, PBJT372.2, PBJT400.2, PBJT401.1, PBJT429.1, PBJT430.2, PBJT650.2, PBJT651.1
C25_R2: PBH458.1, PBH459.1, PBIS24.1, PBIS25.1, PBJP217.2, PBJP218.1, PBJT24.1, PBJT25.2, PBJT53.2, PBJT54.1, PBJT652.1, PBJT653.2
C25_R4: PBH460.1, PBH461.1, PBH462.1, PBIS52.1, PBIS53.1, PBJP218.2, PBJP219.1, PBJT82.1, PBJT83.2, PBJT111.2, PBJT112.1, PBJT140.1, PBJT141.2, PBJT653.1, PBJT654.2
C25_R8: PBH464.1, PBH465.1, PBIS80.1, PBIS81.1, PBJP220.2, PBJP221.1, PBJT169.1, PBJT170.2, PBJT198.2, PBJT199.1, PBJT655.1, PBJT656.2
C25_R10: PBH466.1, PBH467.1, PBH468.1, PBIS108.1, PBIS109.1, PBJP221.2, PBJP222.1, PBJT227.1, PBJT228.2, PBJT256.2, PBJT257.1, PBJT285.1, PBJT286.2, PBJT656.1, PBJT657.2
C25_R14: PBH470.1, PBH471.1, PBIS136.1, PBIS137.1, PBJP223.2, PBJP224.1, PBJT314.1, PBJT315.2, PBJT343.2, PBJT344.1, PBJT658.1, PBJT659.2
C25_R16: PBH472.1, PBH473.1, PBH474.1, PBIS164.1, PBIS165.1, PBJP224.2, PBJP225.1, PBJT372.1, PBJT373.2, PBJT401.2, PBJT402.1, PBJT430.1, PBJT431.2, PBJT659.1, PBJT660.2
C26_R2: PBH477.1, PBH478.1, PBJP226.2, PBJP227.1, PBJT25.1, PBJT26.2, PBJT54.2, PBJT55.1, PBJT661.2, PBJT662.1
C26_R4: PBH479.1, PBH480.1, PBH481.1, PBJP227.2, PBJP228.1, PBJT83.1, PBJT84.2, PBJT112.2, PBJT113.1, PBJT141.1, PBJT142.2, PBJT662.2, PBJT663.1
C26_R8: PBH483.1, PBH484.1, PBJP229.2, PBJP230.1, PBJT170.1, PBJT171.2, PBJT199.2, PBJT200.1, PBJT664.2, PBJT665.1
C26_R10: PBH485.1, PBH486.1, PBH487.1, PBJP230.2, PBJP231.1, PBJT228.1, PBJT229.2, PBJT257.2, PBJT258.1, PBJT286.1, PBJT287.2, PBJT665.2, PBJT666.1
C26_R14: PBH489.1, PBH490.1, PBJP232.2, PBJP233.1, PBJT315.1, PBJT316.2, PBJT344.2, PBJT345.1, PBJT667.2, PBJT668.1
C26_R16: PBH491.1, PBH492.1, PBH493.1, PBJP233.2, PBJP234.1, PBJT373.1, PBJT374.2, PBJT402.2, PBJT403.1, PBJT431.1, PBJT432.2, PBJT668.2, PBJT669.1
C27_R2: PBH496.1, PBH497.1, PBIS26.1, PBIS27.1, PBJP235.2, PBJP236.1, PBJT26.1, PBJT27.2, PBJT55.2, PBJT56.1, PBJT670.1, PBJT671.2
C27_R4: PBH498.1, PBH499.1, PBH500.1, PBIS54.1, PBIS55.1, PBJP236.2, PBJP237.1, PBJT84.1, PBJT85.2, PBJT113.2, PBJT114.1, PBJT142.1, PBJT143.2, PBJT671.1, PBJT672.2
C27_R8: PBH502.1, PBH503.1, PBIS82.1, PBIS83.1, PBJP238.2, PBJP239.1, PBJT171.1, PBJT172.2, PBJT200.2, PBJT201.1, PBJT673.1, PBJT674.2
C27_R10: PBH504.1, PBH505.1, PBH506.1, PBIS110.1, PBIS111.1, PBJP239.2, PBJP240.1, PBJT229.1, PBJT230.2, PBJT258.2, PBJT259.1, PBJT287.1, PBJT288.2, PBJT674.1, PBJT675.2
C27_R14: PBH508.1, PBH509.1, PBIS138.1, PBIS139.1, PBJP241.2, PBJP242.1, PBJT316.1, PBJT317.2, PBJT345.2, PBJT346.1, PBJT676.1, PBJT677.2
C27_R16: PBH510.1, PBH511.1, PBH512.1, PBIS166.1, PBIS167.1, PBJP242.2, PBJP243.1, PBJT374.1, PBJT375.2, PBJT403.2, PBJT404.1, PBJT432.1, PBJT433.2, PBJT677.1, PBJT678.2
C28_R2: PBH515.1, PBH516.1, PBJP244.2, PBJP245.1, PBJT27.1, PBJT28.2, PBJT56.2, PBJT57.1, PBJT679.2, PBJT680.1
C28_R4: PBH517.1, PBH518.1, PBH519.1, PBJP245.2, PBJP246.1, PBJT85.1, PBJT86.2, PBJT114.2, PBJT115.1, PBJT143.1, PBJT144.2, PBJT680.2, PBJT681.1
C28_R8: PBH521.1, PBH522.1, PBJP247.2, PBJP248.1, PBJT172.1, PBJT173.2, PBJT201.2, PBJT202.1, PBJT682.2, PBJT683.1
C28_R10: PBH523.1, PBH524.1, PBH525.1, PBJP248.2, PBJP249.1, PBJT230.1, PBJT231.2, PBJT259.2, PBJT260.1, PBJT288.1, PBJT289.2, PBJT683.2, PBJT684.1
C28_R14: PBH527.1, PBH528.1, PBJP250.2, PBJP251.1, PBJT317.1, PBJT318.2, PBJT346.2, PBJT347.1, PBJT685.2, PBJT686.1
C28_R16: PBH529.1, PBH530.1, PBH531.1, PBJP251.2, PBJP252.1, PBJT375.1, PBJT376.2, PBJT404.2, PBJT405.1, PBJT433.1, PBJT434.2, PBJT686.2, PBJT687.1
C29_R2: PBH534.1, PBH535.1, PBIS28.1, PBJP253.2, PBJP254.1, PBJT28.1, PBJT29.2, PBJT57.2, PBJT58.1, PBJT688.1, PBJT689.2
C29_R4: PBH536.1, PBH537.1, PBH538.1, PBIS56.1, PBJP254.2, PBJP255.1, PBJT86.1, PBJT87.2, PBJT115.2, PBJT116.1, PBJT144.1, PBJT145.2, PBJT689.1, PBJT690.2
C29_R8: PBH540.1, PBH541.1, PBIS84.1, PBJP256.2, PBJP257.1, PBJT173.1, PBJT174.2, PBJT202.2, PBJT203.1, PBJT691.1, PBJT692.2
C29_R10: PBH542.1, PBH543.1, PBH544.1, PBIS112.1, PBJP257.2, PBJP258.1, PBJT231.1, PBJT232.2, PBJT260.2, PBJT261.1, PBJT289.1, PBJT290.2, PBJT692.1, PBJT693.2
C29_R14: PBH546.1, PBH547.1, PBIS140.1, PBJP259.2, PBJP260.1, PBJT318.1, PBJT319.2, PBJT347.2, PBJT348.1, PBJT694.1, PBJT695.2
C29_R16: PBH548.1, PBH549.1, PBH550.1, PBIS168.1, PBJP260.2, PBJP261.1, PBJT376.1, PBJT377.2, PBJT405.2, PBJT406.1, PBJT434.1, PBJT435.2, PBJT695.1, PBJT696.2
C30_R2: PBH553.1, PBH554.1, PBJP262.2, PBJP263.1, PBJT29.1, PBJT58.2, PBJT697.2, PBJT698.1
C30_R4: PBH555.1, PBH556.1, PBH557.1, PBJP263.2, PBJP264.1, PBJT87.1, PBJT116.2, PBJT145.1, PBJT698.2, PBJT699.1
C30_R8: PBH559.1, PBH560.1, PBJP265.2, PBJP266.1, PBJT174.1, PBJT203.2, PBJT700.2, PBJT701.1
C30_R10: PBH561.1, PBH562.1, PBH563.1, PBJP266.2, PBJP267.1, PBJT232.1, PBJT261.2, PBJT290.1, PBJT701.2, PBJT702.1
C30_R14: PBH565.1, PBH566.1, PBJP268.2, PBJP269.1, PBJT319.1, PBJT348.2, PBJT703.2, PBJT704.1
C30_R16: PBH567.1, PBH568.1, PBH569.1, PBJP269.2, PBJP270.1, PBJT377.1, PBJT406.2, PBJT435.1, PBJT704.2, PBJT705.1
