mcesar67/MCboard/examples/classic_64x20/MCboard_64x20.kicad_pcb

## KiCad design examples/classic_64x20/MCboard_64x20.kicad_pcb (2026-11-11)

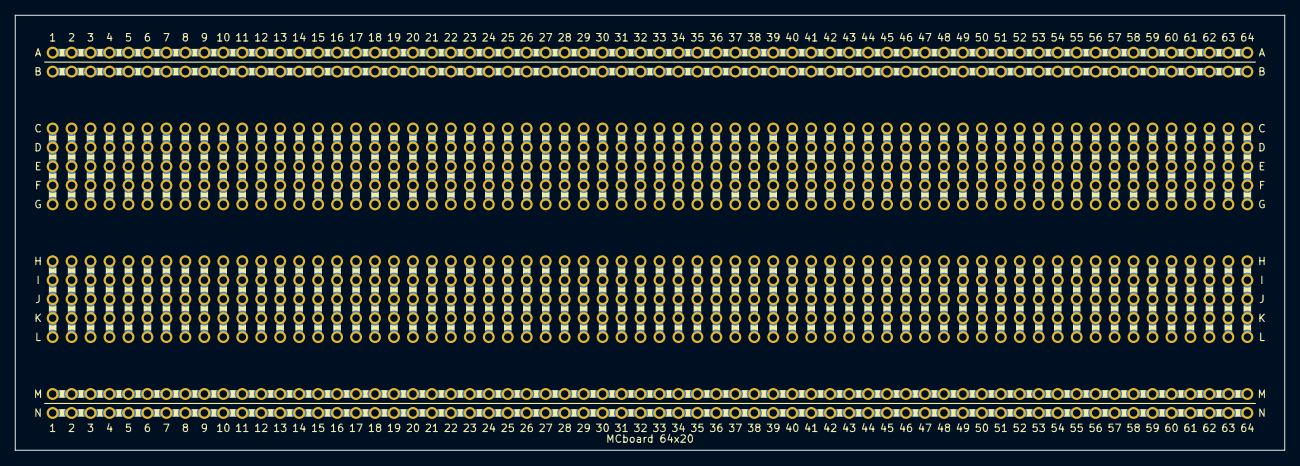
[picture p8: board MCboard_64x20.kicad_pcb from above]

Board: 2 copper layers, 170.0 x 58.3 mm, 896 parts (0 on the bottom side), 132 nets.

Parts:
PBH1, PBH2, PBH3, PBH4, PBH5, PBH6, PBH7, PBH8, PBH9, PBH10, PBH11, PBH12, PBH13, PBH14, PBH15, PBH16, PBH17, PBH18, PBH19, PBH20, PBH21, PBH22, PBH23, PBH24, PBH25, PBH26, PBH27, PBH28, PBH29, PBH30, PBH31, PBH32, PBH33, PBH34, PBH35, PBH36, PBH37, PBH38, PBH39, PBH40, PBH41, PBH42, PBH43, PBH44, PBH45, PBH46, PBH47, PBH48, PBH49, PBH50, PBH51, PBH52, PBH53, PBH54, PBH55, PBH56, PBH57, PBH58, PBH59, PBH60, PBH61, PBH62, PBH63, PBH64, PBH65, PBH66, PBH67, PBH68, PBH69, PBH70, PBH71, PBH72, PBH73, PBH74, PBH75, PBH76, PBH77, PBH78, PBH79, PBH80, PBH81, PBH82, PBH83, PBH84, PBH85, PBH86, PBH87, PBH88, PBH89, PBH90, PBH91, PBH92, PBH93, PBH94, PBH95, PBH96, PBH97, PBH98, PBH99, PBH100, PBH101, PBH102, PBH103, PBH104, PBH105, PBH106, PBH107, PBH108, PBH109, PBH110, PBH111, PBH112, PBH113, PBH114, PBH115, PBH116, PBH117, PBH118, PBH119, PBH120, PBH121, PBH122, PBH123, PBH124, PBH125, PBH126, PBH127, PBH128, PBH129, PBH130, PBH131, PBH132, PBH133, PBH134, PBH135, PBH136, PBH137, PBH138, PBH139, PBH140, PBH141, PBH142, PBH143, PBH144, PBH145, PBH146, PBH147, PBH148, PBH149, PBH150, PBH151, PBH152, PBH153, PBH154, PBH155, PBH156, PBH157, PBH158, PBH159, PBH160, PBH161, PBH162, PBH163, PBH164, PBH165, PBH166, PBH167, PBH168, PBH169, PBH170, PBH171, PBH172, PBH173, PBH174, PBH175, PBH176, PBH177, PBH178, PBH179, PBH180, PBH181, PBH182, PBH183, PBH184, PBH185, PBH186, PBH187, PBH188, PBH189, PBH190, PBH191, PBH192, PBH193, PBH194, PBH195, PBH196, PBH197, PBH198, PBH199, PBH200, PBH201, PBH202, PBH203, PBH204, PBH205, PBH206, PBH207, PBH208, PBH209, PBH210, PBH211, PBH212, PBH213, PBH214, PBH215, PBH216, PBH217, PBH218, PBH219, PBH220, PBH221, PBH222, PBH223, PBH224, PBH225, PBH226, PBH227, PBH228, PBH229, PBH230, PBH231, PBH232, PBH233, PBH234, PBH235, PBH236, PBH237, PBH238, PBH239, PBH240, PBH241, PBH242, PBH243, PBH244, PBH245, PBH246, PBH247, PBH248, PBH249, PBH250, PBH251, PBH252, PBH253, PBH254, PBH255, PBH256, PBH257, PBH258, PBH259, PBH260, PBH261, PBH262, PBH263, PBH264, PBH265, PBH266, PBH267, PBH268, PBH269, PBH270, PBH271, PBH272, PBH273, PBH274, PBH275, PBH276, PBH277, PBH278, PBH279, PBH280, PBH281, PBH282, PBH283, PBH284, PBH285, PBH286, PBH287, PBH288, PBH289, PBH290, PBH291, PBH292, PBH293, PBH294, PBH295, PBH296, PBH297, PBH298, PBH299, PBH300, PBH301, PBH302, PBH303, PBH304, PBH305, PBH306, PBH307, PBH308, PBH309, PBH310, PBH311, PBH312, PBH313, PBH314, PBH315, PBH316, PBH317, PBH318, PBH319, PBH320, PBH321, PBH322, PBH323, PBH324, PBH325, PBH326, PBH327, PBH328, PBH329, PBH330, PBH331, PBH332, PBH333, PBH334, PBH335, PBH336, PBH337, PBH338, PBH339, PBH340, PBH341, PBH342, PBH343, PBH344, PBH345, PBH346, PBH347, PBH348, PBH349, PBH350, PBH351, PBH352, PBH353, PBH354, PBH355, PBH356, PBH357, PBH358, PBH359, PBH360, PBH361, PBH362, PBH363, PBH364, PBH365, PBH366, PBH367, PBH368, PBH369, PBH370, PBH371, PBH372, PBH373, PBH374, PBH375, PBH376, PBH377, PBH378, PBH379, PBH380, PBH381, PBH382, PBH383, PBH384, PBH385, PBH386, PBH387, PBH388, PBH389, PBH390, PBH391, PBH392, PBH393, PBH394, PBH395, PBH396, PBH397, PBH398, PBH399, PBH400, PBH401, PBH402, PBH403, PBH404, PBH405, PBH406, PBH407, PBH408, PBH409, PBH410, PBH411, PBH412, PBH413, PBH414, PBH415, PBH416, PBH417, PBH418, PBH419, PBH420, PBH421, PBH422, PBH423, PBH424, PBH425, PBH426, PBH427, PBH428, PBH429, PBH430, PBH431, PBH432, PBH433, PBH434, PBH435, PBH436, PBH437, PBH438, PBH439, PBH440, PBH441, PBH442, PBH443, PBH444, PBH445, PBH446, PBH447, PBH448, PBH449, PBH450, PBH451, PBH452, PBH453, PBH454, PBH455, PBH456, PBH457, PBH458, PBH459, PBH460, PBH461, PBH462, PBH463, PBH464, PBH465, PBH466, PBH467, PBH468, PBH469, PBH470, PBH471, PBH472, PBH473, PBH474, PBH475, PBH476, PBH477, PBH478, PBH479, PBH480, PBH481, PBH482, PBH483, PBH484, PBH485, PBH486, PBH487, PBH488, PBH489, PBH490, PBH491, PBH492, PBH493, PBH494, PBH495, PBH496, PBH497, PBH498, PBH499, PBH500, PBH501, PBH502, PBH503, PBH504, PBH505, PBH506, PBH507, PBH508, PBH509, PBH510, PBH511, PBH512, PBH513, PBH514, PBH515, PBH516, PBH517, PBH518, PBH519, PBH520, PBH521, PBH522, PBH523, PBH524, PBH525, PBH526, PBH527, PBH528, PBH529, PBH530, PBH531, PBH532, PBH533, PBH534, PBH535, PBH536, PBH537, PBH538, PBH539, PBH540, PBH541, PBH542, PBH543, PBH544, PBH545, PBH546, PBH547, PBH548, PBH549, PBH550, PBH551, PBH552, PBH553, PBH554, PBH555, PBH556, PBH557, PBH558, PBH559, PBH560, PBH561, PBH562, PBH563, PBH564, PBH565, PBH566, PBH567, PBH568, PBH569, PBH570, PBH571, PBH572, PBH573, PBH574, PBH575, PBH576, PBH577, PBH578, PBH579, PBH580, PBH581, PBH582, PBH583, PBH584, PBH585, PBH586, PBH587, PBH588, PBH589, PBH590, PBH591, PBH592, PBH593, PBH594, PBH595, PBH596, PBH597, PBH598, PBH599, PBH600, PBH601, PBH602, PBH603, PBH604, PBH605, PBH606, PBH607, PBH608, PBH609, PBH610, PBH611, PBH612, PBH613, PBH614, PBH615, PBH616, PBH617, PBH618, PBH619, PBH620, PBH621, PBH622, PBH623, PBH624, PBH625, PBH626, PBH627, PBH628, PBH629, PBH630, PBH631, PBH632, PBH633, PBH634, PBH635, PBH636, PBH637, PBH638, PBH639, PBH640, PBH641, PBH642, PBH643, PBH644, PBH645, PBH646, PBH647, PBH648, PBH649, PBH650, PBH651, PBH652, PBH653, PBH654, PBH655, PBH656, PBH657, PBH658, PBH659, PBH660, PBH661, PBH662, PBH663, PBH664, PBH665, PBH666, PBH667, PBH668, PBH669, PBH670, PBH671, PBH672, PBH673, PBH674, PBH675, PBH676, PBH677, PBH678, PBH679, PBH680, PBH681, PBH682, PBH683, PBH684, PBH685, PBH686, PBH687, PBH688, PBH689, PBH690, PBH691, PBH692, PBH693, PBH694, PBH695, PBH696, PBH697, PBH698, PBH699, PBH700, PBH701, PBH702, PBH703, PBH704, PBH705, PBH706, PBH707, PBH708, PBH709, PBH710, PBH711, PBH712, PBH713, PBH714, PBH715, PBH716, PBH717, PBH718, PBH719, PBH720, PBH721, PBH722, PBH723, PBH724, PBH725, PBH726, PBH727, PBH728, PBH729, PBH730, PBH731, PBH732, PBH733, PBH734, PBH735, PBH736, PBH737, PBH738, PBH739, PBH740, PBH741, PBH742, PBH743, PBH744, PBH745, PBH746, PBH747, PBH748, PBH749, PBH750, PBH751, PBH752, PBH753, PBH754, PBH755, PBH756, PBH757, PBH758, PBH759, PBH760, PBH761, PBH762, PBH763, PBH764, PBH765, PBH766, PBH767, PBH768, PBH769, PBH770, PBH771, PBH772, PBH773, PBH774, PBH775, PBH776, PBH777, PBH778, PBH779, PBH780, PBH781, PBH782, PBH783, PBH784, PBH785, PBH786, PBH787, PBH788, PBH789, PBH790, PBH791, PBH792, PBH793, PBH794, PBH795, PBH796, PBH797, PBH798, PBH799, PBH800, PBH801, PBH802, PBH803, PBH804, PBH805, PBH806, PBH807, PBH808, PBH809, PBH810, PBH811, PBH812, PBH813, PBH814, PBH815, PBH816, PBH817, PBH818, PBH819, PBH820, PBH821, PBH822, PBH823, PBH824, PBH825, PBH826, PBH827, PBH828, PBH829, PBH830, PBH831, PBH832, PBH833, PBH834, PBH835, PBH836, PBH837, PBH838, PBH839, PBH840, PBH841, PBH842, PBH843, PBH844, PBH845, PBH846, PBH847, PBH848, PBH849, PBH850, PBH851, PBH852, PBH853, PBH854, PBH855, PBH856, PBH857, PBH858, PBH859, PBH860, PBH861, PBH862, PBH863, PBH864, PBH865, PBH866, PBH867, PBH868, PBH869, PBH870, PBH871, PBH872, PBH873, PBH874, PBH875, PBH876, PBH877, PBH878, PBH879, PBH880, PBH881, PBH882, PBH883, PBH884, PBH885, PBH886, PBH887, PBH888, PBH889, PBH890, PBH891, PBH892, PBH893, PBH894, PBH895, PBH896: hole; Hole

Connections:
BUS_R1: PBH1.1, PBH15.1, PBH29.1, PBH43.1, PBH57.1, PBH71.1, PBH85.1, PBH99.1, PBH113.1, PBH127.1, PBH141.1, PBH155.1, PBH169.1, PBH183.1, PBH197.1, PBH211.1, PBH225.1, PBH239.1, PBH253.1, PBH267.1, PBH281.1, PBH295.1, PBH309.1, PBH323.1, PBH337.1, PBH351.1, PBH365.1, PBH379.1, PBH393.1, PBH407.1, PBH421.1, PBH435.1, PBH449.1, PBH463.1, PBH477.1, PBH491.1, PBH505.1, PBH519.1, PBH533.1, PBH547.1, PBH561.1, PBH575.1, PBH589.1, PBH603.1, PBH617.1, PBH631.1, PBH645.1, PBH659.1, PBH673.1, PBH687.1, PBH701.1, PBH715.1, PBH729.1, PBH743.1, PBH757.1, PBH771.1, PBH785.1, PBH799.1, PBH813.1, PBH827.1, PBH841.1, PBH855.1, PBH869.1, PBH883.1
BUS_R2: PBH2.1, PBH16.1, PBH30.1, PBH44.1, PBH58.1, PBH72.1, PBH86.1, PBH100.1, PBH114.1, PBH128.1, PBH142.1, PBH156.1, PBH170.1, PBH184.1, PBH198.1, PBH212.1, PBH226.1, PBH240.1, PBH254.1, PBH268.1, PBH282.1, PBH296.1, PBH310.1, PBH324.1, PBH338.1, PBH352.1, PBH366.1, PBH380.1, PBH394.1, PBH408.1, PBH422.1, PBH436.1, PBH450.1, PBH464.1, PBH478.1, PBH492.1, PBH506.1, PBH520.1, PBH534.1, PBH548.1, PBH562.1, PBH576.1, PBH590.1, PBH604.1, PBH618.1, PBH632.1, PBH646.1, PBH660.1, PBH674.1, PBH688.1, PBH702.1, PBH716.1, PBH730.1, PBH744.1, PBH758.1, PBH772.1, PBH786.1, PBH800.1, PBH814.1, PBH828.1, PBH842.1, PBH856.1, PBH870.1, PBH884.1
BUS_R13: PBH13.1, PBH27.1, PBH41.1, PBH55.1, PBH69.1, PBH83.1, PBH97.1, PBH111.1, PBH125.1, PBH139.1, PBH153.1, PBH167.1, PBH181.1, PBH195.1, PBH209.1, PBH223.1, PBH237.1, PBH251.1, PBH265.1, PBH279.1, PBH293.1, PBH307.1, PBH321.1, PBH335.1, PBH349.1, PBH363.1, PBH377.1, PBH391.1, PBH405.1, PBH419.1, PBH433.1, PBH447.1, PBH461.1, PBH475.1, PBH489.1, PBH503.1, PBH517.1, PBH531.1, PBH545.1, PBH559.1, PBH573.1, PBH587.1, PBH601.1, PBH615.1, PBH629.1, PBH643.1, PBH657.1, PBH671.1, PBH685.1, PBH699.1, PBH713.1, PBH727.1, PBH741.1, PBH755.1, PBH769.1, PBH783.1, PBH797.1, PBH811.1, PBH825.1, PBH839.1, PBH853.1, PBH867.1, PBH881.1, PBH895.1
BUS_R14: PBH14.1, PBH28.1, PBH42.1, PBH56.1, PBH70.1, PBH84.1, PBH98.1, PBH112.1, PBH126.1, PBH140.1, PBH154.1, PBH168.1, PBH182.1, PBH196.1, PBH210.1, PBH224.1, PBH238.1, PBH252.1, PBH266.1, PBH280.1, PBH294.1, PBH308.1, PBH322.1, PBH336.1, PBH350.1, PBH364.1, PBH378.1, PBH392.1, PBH406.1, PBH420.1, PBH434.1, PBH448.1, PBH462.1, PBH476.1, PBH490.1, PBH504.1, PBH518.1, PBH532.1, PBH546.1, PBH560.1, PBH574.1, PBH588.1, PBH602.1, PBH616.1, PBH630.1, PBH644.1, PBH658.1, PBH672.1, PBH686.1, PBH700.1, PBH714.1, PBH728.1, PBH742.1, PBH756.1, PBH770.1, PBH784.1, PBH798.1, PBH812.1, PBH826.1, PBH840.1, PBH854.1, PBH868.1, PBH882.1, PBH896.1
C1_R3: PBH3.1, PBH4.1, PBH5.1, PBH6.1, PBH7.1
C1_R8: PBH8.1, PBH9.1, PBH10.1, PBH11.1, PBH12.1
C2_R3: PBH17.1, PBH18.1, PBH19.1, PBH20.1, PBH21.1
C2_R8: PBH22.1, PBH23.1, PBH24.1, PBH25.1, PBH26.1
C3_R3: PBH31.1, PBH32.1, PBH33.1, PBH34.1, PBH35.1
C3_R8: PBH36.1, PBH37.1, PBH38.1, PBH39.1, PBH40.1
C4_R3: PBH45.1, PBH46.1, PBH47.1, PBH48.1, PBH49.1
C4_R8: PBH50.1, PBH51.1, PBH52.1, PBH53.1, PBH54.1
C5_R3: PBH59.1, PBH60.1, PBH61.1, PBH62.1, PBH63.1
C5_R8: PBH64.1, PBH65.1, PBH66.1, PBH67.1, PBH68.1
C6_R3: PBH73.1, PBH74.1, PBH75.1, PBH76.1, PBH77.1
C6_R8: PBH78.1, PBH79.1, PBH80.1, PBH81.1, PBH82.1
C7_R3: PBH87.1, PBH88.1, PBH89.1, PBH90.1, PBH91.1
C7_R8: PBH92.1, PBH93.1, PBH94.1, PBH95.1, PBH96.1
C8_R3: PBH101.1, PBH102.1, PBH103.1, PBH104.1, PBH105.1
C8_R8: PBH106.1, PBH107.1, PBH108.1, PBH109.1, PBH110.1
C9_R3: PBH115.1, PBH116.1, PBH117.1, PBH118.1, PBH119.1
C9_R8: PBH120.1, PBH121.1, PBH122.1, PBH123.1, PBH124.1
C10_R3: PBH129.1, PBH130.1, PBH131.1, PBH132.1, PBH133.1
C10_R8: PBH134.1, PBH135.1, PBH136.1, PBH137.1, PBH138.1
C11_R3: PBH143.1, PBH144.1, PBH145.1, PBH146.1, PBH147.1
C11_R8: PBH148.1, PBH149.1, PBH150.1, PBH151.1, PBH152.1
C12_R3: PBH157.1, PBH158.1, PBH159.1, PBH160.1, PBH161.1
C12_R8: PBH162.1, PBH163.1, PBH164.1, PBH165.1, PBH166.1
C13_R3: PBH171.1, PBH172.1, PBH173.1, PBH174.1, PBH175.1
C13_R8: PBH176.1, PBH177.1, PBH178.1, PBH179.1, PBH180.1
C14_R3: PBH185.1, PBH186.1, PBH187.1, PBH188.1, PBH189.1
C14_R8: PBH190.1, PBH191.1, PBH192.1, PBH193.1, PBH194.1
C15_R3: PBH199.1, PBH200.1, PBH201.1, PBH202.1, PBH203.1
C15_R8: PBH204.1, PBH205.1, PBH206.1, PBH207.1, PBH208.1
C16_R3: PBH213.1, PBH214.1, PBH215.1, PBH216.1, PBH217.1
C16_R8: PBH218.1, PBH219.1, PBH220.1, PBH221.1, PBH222.1
C17_R3: PBH227.1, PBH228.1, PBH229.1, PBH230.1, PBH231.1
C17_R8: PBH232.1, PBH233.1, PBH234.1, PBH235.1, PBH236.1
C18_R3: PBH241.1, PBH242.1, PBH243.1, PBH244.1, PBH245.1
C18_R8: PBH246.1, PBH247.1, PBH248.1, PBH249.1, PBH250.1
C19_R3: PBH255.1, PBH256.1, PBH257.1, PBH258.1, PBH259.1
C19_R8: PBH260.1, PBH261.1, PBH262.1, PBH263.1, PBH264.1
C20_R3: PBH269.1, PBH270.1, PBH271.1, PBH272.1, PBH273.1
C20_R8: PBH274.1, PBH275.1, PBH276.1, PBH277.1, PBH278.1
C21_R3: PBH283.1, PBH284.1, PBH285.1, PBH286.1, PBH287.1
C21_R8: PBH288.1, PBH289.1, PBH290.1, PBH291.1, PBH292.1
C22_R3: PBH297.1, PBH298.1, PBH299.1, PBH300.1, PBH301.1
C22_R8: PBH302.1, PBH303.1, PBH304.1, PBH305.1, PBH306.1
C23_R3: PBH311.1, PBH312.1, PBH313.1, PBH314.1, PBH315.1
C23_R8: PBH316.1, PBH317.1, PBH318.1, PBH319.1, PBH320.1
C24_R3: PBH325.1, PBH326.1, PBH327.1, PBH328.1, PBH329.1
C24_R8: PBH330.1, PBH331.1, PBH332.1, PBH333.1, PBH334.1
C25_R3: PBH339.1, PBH340.1, PBH341.1, PBH342.1, PBH343.1
C25_R8: PBH344.1, PBH345.1, PBH346.1, PBH347.1, PBH348.1
C26_R3: PBH353.1, PBH354.1, PBH355.1, PBH356.1, PBH357.1
C26_R8: PBH358.1, PBH359.1, PBH360.1, PBH361.1, PBH362.1
C27_R3: PBH367.1, PBH368.1, PBH369.1, PBH370.1, PBH371.1
C27_R8: PBH372.1, PBH373.1, PBH374.1, PBH375.1, PBH376.1
C28_R3: PBH381.1, PBH382.1, PBH383.1, PBH384.1, PBH385.1
C28_R8: PBH386.1, PBH387.1, PBH388.1, PBH389.1, PBH390.1
C29_R3: PBH395.1, PBH396.1, PBH397.1, PBH398.1, PBH399.1
C29_R8: PBH400.1, PBH401.1, PBH402.1, PBH403.1, PBH404.1
C30_R3: PBH409.1, PBH410.1, PBH411.1, PBH412.1, PBH413.1
C30_R8: PBH414.1, PBH415.1, PBH416.1, PBH417.1, PBH418.1
C31_R3: PBH423.1, PBH424.1, PBH425.1, PBH426.1, PBH427.1
C31_R8: PBH428.1, PBH429.1, PBH430.1, PBH431.1, PBH432.1
C32_R3: PBH437.1, PBH438.1, PBH439.1, PBH440.1, PBH441.1
C32_R8: PBH442.1, PBH443.1, PBH444.1, PBH445.1, PBH446.1
C33_R3: PBH451.1, PBH452.1, PBH453.1, PBH454.1, PBH455.1
C33_R8: PBH456.1, PBH457.1, PBH458.1, PBH459.1, PBH460.1
C34_R3: PBH465.1, PBH466.1, PBH467.1, PBH468.1, PBH469.1
C34_R8: PBH470.1, PBH471.1, PBH472.1, PBH473.1, PBH474.1
C35_R3: PBH479.1, PBH480.1, PBH481.1, PBH482.1, PBH483.1
C35_R8: PBH484.1, PBH485.1, PBH486.1, PBH487.1, PBH488.1
C36_R3: PBH493.1, PBH494.1, PBH495.1, PBH496.1, PBH497.1
C36_R8: PBH498.1, PBH499.1, PBH500.1, PBH501.1, PBH502.1
C37_R3: PBH507.1, PBH508.1, PBH509.1, PBH510.1, PBH511.1
C37_R8: PBH512.1, PBH513.1, PBH514.1, PBH515.1, PBH516.1
C38_R3: PBH521.1, PBH522.1, PBH523.1, PBH524.1, PBH525.1
C38_R8: PBH526.1, PBH527.1, PBH528.1, PBH529.1, PBH530.1
C39_R3: PBH535.1, PBH536.1, PBH537.1, PBH538.1, PBH539.1
C39_R8: PBH540.1, PBH541.1, PBH542.1, PBH543.1, PBH544.1
C40_R3: PBH549.1, PBH550.1, PBH551.1, PBH552.1, PBH553.1
C40_R8: PBH554.1, PBH555.1, PBH556.1, PBH557.1, PBH558.1
C41_R3: PBH563.1, PBH564.1, PBH565.1, PBH566.1, PBH567.1
C41_R8: PBH568.1, PBH569.1, PBH570.1, PBH571.1, PBH572.1
C42_R3: PBH577.1, PBH578.1, PBH579.1, PBH580.1, PBH581.1
C42_R8: PBH582.1, PBH583.1, PBH584.1, PBH585.1, PBH586.1
C43_R3: PBH591.1, PBH592.1, PBH593.1, PBH594.1, PBH595.1
C43_R8: PBH596.1, PBH597.1, PBH598.1, PBH599.1, PBH600.1
C44_R3: PBH605.1, PBH606.1, PBH607.1, PBH608.1, PBH609.1
C44_R8: PBH610.1, PBH611.1, PBH612.1, PBH613.1, PBH614.1
C45_R3: PBH619.1, PBH620.1, PBH621.1, PBH622.1, PBH623.1
C45_R8: PBH624.1, PBH625.1, PBH626.1, PBH627.1, PBH628.1
C46_R3: PBH633.1, PBH634.1, PBH635.1, PBH636.1, PBH637.1
C46_R8: PBH638.1, PBH639.1, PBH640.1, PBH641.1, PBH642.1
C47_R3: PBH647.1, PBH648.1, PBH649.1, PBH650.1, PBH651.1
C47_R8: PBH652.1, PBH653.1, PBH654.1, PBH655.1, PBH656.1
C48_R3: PBH661.1, PBH662.1, PBH663.1, PBH664.1, PBH665.1
C48_R8: PBH666.1, PBH667.1, PBH668.1, PBH669.1, PBH670.1
C49_R3: PBH675.1, PBH676.1, PBH677.1, PBH678.1, PBH679.1
C49_R8: PBH680.1, PBH681.1, PBH682.1, PBH683.1, PBH684.1
C50_R3: PBH689.1, PBH690.1, PBH691.1, PBH692.1, PBH693.1
C50_R8: PBH694.1, PBH695.1, PBH696.1, PBH697.1, PBH698.1
C51_R3: PBH703.1, PBH704.1, PBH705.1, PBH706.1, PBH707.1
C51_R8: PBH708.1, PBH709.1, PBH710.1, PBH711.1, PBH712.1
C52_R3: PBH717.1, PBH718.1, PBH719.1, PBH720.1, PBH721.1
C52_R8: PBH722.1, PBH723.1, PBH724.1, PBH725.1, PBH726.1
C53_R3: PBH731.1, PBH732.1, PBH733.1, PBH734.1, PBH735.1
C53_R8: PBH736.1, PBH737.1, PBH738.1, PBH739.1, PBH740.1
C54_R3: PBH745.1, PBH746.1, PBH747.1, PBH748.1, PBH749.1
C54_R8: PBH750.1, PBH751.1, PBH752.1, PBH753.1, PBH754.1
C55_R3: PBH759.1, PBH760.1, PBH761.1, PBH762.1, PBH763.1
C55_R8: PBH764.1, PBH765.1, PBH766.1, PBH767.1, PBH768.1
C56_R3: PBH773.1, PBH774.1, PBH775.1, PBH776.1, PBH777.1
C56_R8: PBH778.1, PBH779.1, PBH780.1, PBH781.1, PBH782.1
C57_R3: PBH787.1, PBH788.1, PBH789.1, PBH790.1, PBH791.1
C57_R8: PBH792.1, PBH793.1, PBH794.1, PBH795.1, PBH796.1
C58_R3: PBH801.1, PBH802.1, PBH803.1, PBH804.1, PBH805.1
C58_R8: PBH806.1, PBH807.1, PBH808.1, PBH809.1, PBH810.1
C59_R3: PBH815.1, PBH816.1, PBH817.1, PBH818.1, PBH819.1
C59_R8: PBH820.1, PBH821.1, PBH822.1, PBH823.1, PBH824.1
C60_R3: PBH829.1, PBH830.1, PBH831.1, PBH832.1, PBH833.1
C60_R8: PBH834.1, PBH835.1, PBH836.1, PBH837.1, PBH838.1
C61_R3: PBH843.1, PBH844.1, PBH845.1, PBH846.1, PBH847.1
C61_R8: PBH848.1, PBH849.1, PBH850.1, PBH851.1, PBH852.1
C62_R3: PBH857.1, PBH858.1, PBH859.1, PBH860.1, PBH861.1
C62_R8: PBH862.1, PBH863.1, PBH864.1, PBH865.1, PBH866.1
C63_R3: PBH871.1, PBH872.1, PBH873.1, PBH874.1, PBH875.1
C63_R8: PBH876.1, PBH877.1, PBH878.1, PBH879.1, PBH880.1
C64_R3: PBH885.1, PBH886.1, PBH887.1, PBH888.1, PBH889.1
C64_R8: PBH890.1, PBH891.1, PBH892.1, PBH893.1, PBH894.1
