mcesar67/MCboard/tests/t555/imported.kicad_pcb

## KiCad design tests/t555/imported.kicad_pcb (2026-11-08)

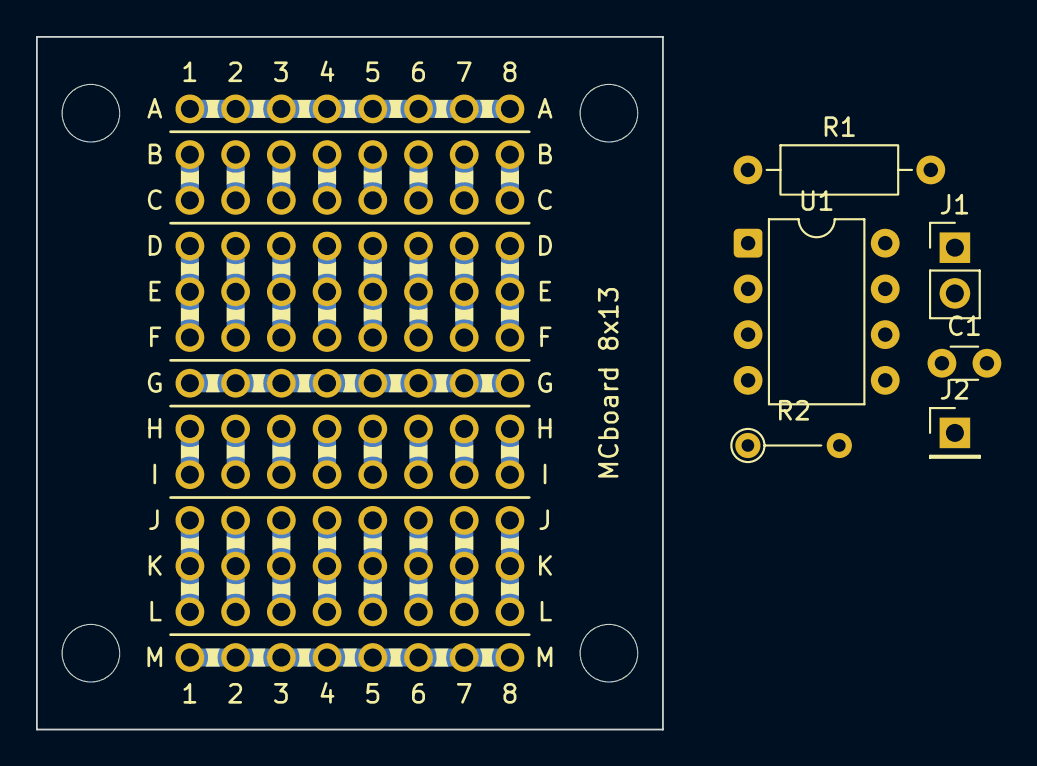
[picture p9: board imported.kicad_pcb from above]

Board: 2 copper layers, 34.8 x 38.5 mm, 162 parts (0 on the bottom side), 40 nets.

Parts:
C1: 100n; C_Disc_D3.0mm_W1.6mm_P2.50mm
H1, H2, H3, H4, H5, H6, H7, H8, H9, H10, H11, H12, H13, H14, H15, H16, H17, H18, H19, H20, H21, H22, H23, H24, H25, H26, H27, H28, H29, H30, H31, H32, H33, H34, H35, H36, H37, H38, H39, H40, H41, H42, H43, H44, H45, H46, H47, H48, H49, H50, H51, H52, H53, H54, H55, H56, H57, H58, H59, H60, H61, H62, H63, H64, H65, H66, H67, H68, H69, H70, H71, H72, H73, H74, H75, H76, H77, H78, H79, H80, H81, H82, H83, H84, H85, H86, H87, H88, H89, H90, H91, H92, H93, H94, H95, H96, H97, H98, H99, H100, H101, H102, H103, H104: hole; Hole
J1: PWR; PinHeader_1x02_P2.54mm_Vertical
J2: OUT; PinHeader_1x01_P2.54mm_Vertical
JP1, JP2, JP3, JP4, JP5, JP6, JP7, JP8, JP9, JP10, JP11, JP12, JP13, JP14, JP15, JP16, JP17, JP18, JP19, JP20, JP21, JP22, JP23, JP24, JP25, JP26, JP27, JP28, JP29, JP30, JP31, JP32, JP33, JP34, JP35, JP36, JP37, JP38, JP39, JP40, JP41, JP42, JP43, JP44, JP45, JP46, JP47, JP48: chevron; ChevronJumper
MH1, MH2, MH3, MH4: mounting hole; MountingHole
R1: 10k; R_Axial_DIN0207_L6.3mm_D2.5mm_P10.16mm_Horizontal
R2: 47k; R_Axial_DIN0204_L3.6mm_D1.6mm_P5.08mm_Vertical
U1: NE555; DIP-8_W7.62mm

Connections:
BUS_R1: H1.1, H14.1, H27.1, H40.1, H53.1, H66.1, H79.1, H92.1, JP1.1, JP7.1, JP13.1, JP19.1, JP25.1, JP31.1, JP37.1, JP43.1
BUS_R7: H7.1, H20.1, H33.1, H46.1, H59.1, H72.1, H85.1, H98.1, JP3.2, JP4.1, JP9.2, JP10.1, JP15.2, JP16.1, JP21.2, JP22.1, JP27.2, JP28.1, JP33.2, JP34.1, JP39.2, JP40.1, JP45.2, JP46.1
BUS_R13: H13.1, H26.1, H39.1, H52.1, H65.1, H78.1, H91.1, H104.1, JP6.2, JP12.2, JP18.2, JP24.2, JP30.2, JP36.2, JP42.2, JP48.2
C1_R2: H2.1, H3.1, JP1.2, JP2.1
C1_R4: H4.1, H5.1, H6.1, JP2.2, JP3.1
C1_R8: H8.1, H9.1, JP4.2, JP5.1
C1_R10: H10.1, H11.1, H12.1, JP5.2, JP6.1
C2_R2: H15.1, H16.1, JP7.2, JP8.1
C2_R4: H17.1, H18.1, H19.1, JP8.2, JP9.1
C2_R8: H21.1, H22.1, JP10.2, JP11.1
C2_R10: H23.1, H24.1, H25.1, JP11.2, JP12.1
C3_R2: H28.1, H29.1, JP13.2, JP14.1
C3_R4: H30.1, H31.1, H32.1, JP14.2, JP15.1
C3_R8: H34.1, H35.1, JP16.2, JP17.1
C3_R10: H36.1, H37.1, H38.1, JP17.2, JP18.1
C4_R2: H41.1, H42.1, JP19.2, JP20.1
C4_R4: H43.1, H44.1, H45.1, JP20.2, JP21.1
C4_R8: H47.1, H48.1, JP22.2, JP23.1
C4_R10: H49.1, H50.1, H51.1, JP23.2, JP24.1
C5_R2: H54.1, H55.1, JP25.2, JP26.1
C5_R4: H56.1, H57.1, H58.1, JP26.2, JP27.1
C5_R8: H60.1, H61.1, JP28.2, JP29.1
C5_R10: H62.1, H63.1, H64.1, JP29.2, JP30.1
C6_R2: H67.1, H68.1, JP31.2, JP32.1
C6_R4: H69.1, H70.1, H71.1, JP32.2, JP33.1
C6_R8: H73.1, H74.1, JP34.2, JP35.1
C6_R10: H75.1, H76.1, H77.1, JP35.2, JP36.1
C7_R2: H80.1, H81.1, JP37.2, JP38.1
C7_R4: H82.1, H83.1, H84.1, JP38.2, JP39.1
C7_R8: H86.1, H87.1, JP40.2, JP41.1
C7_R10: H88.1, H89.1, H90.1, JP41.2, JP42.1
C8_R2: H93.1, H94.1, JP43.2, JP44.1
C8_R4: H95.1, H96.1, H97.1, JP44.2, JP45.1
C8_R8: H99.1, H100.1, JP46.2, JP47.1
C8_R10: H101.1, H102.1, H103.1, JP47.2, JP48.1
DIS: R1.1, R2.2, U1.7
GND: C1.2, J1.2, U1.1
OUT: J2.1, U1.3
TRIG: C1.1, R2.1, U1.2, U1.6
VCC: J1.1, R1.2, U1.4, U1.8
