mcesar67/MCboard/tests/t555/placed_across_bus.kicad_pcb

## KiCad design tests/t555/placed_across_bus.kicad_pcb (2026-11-08)

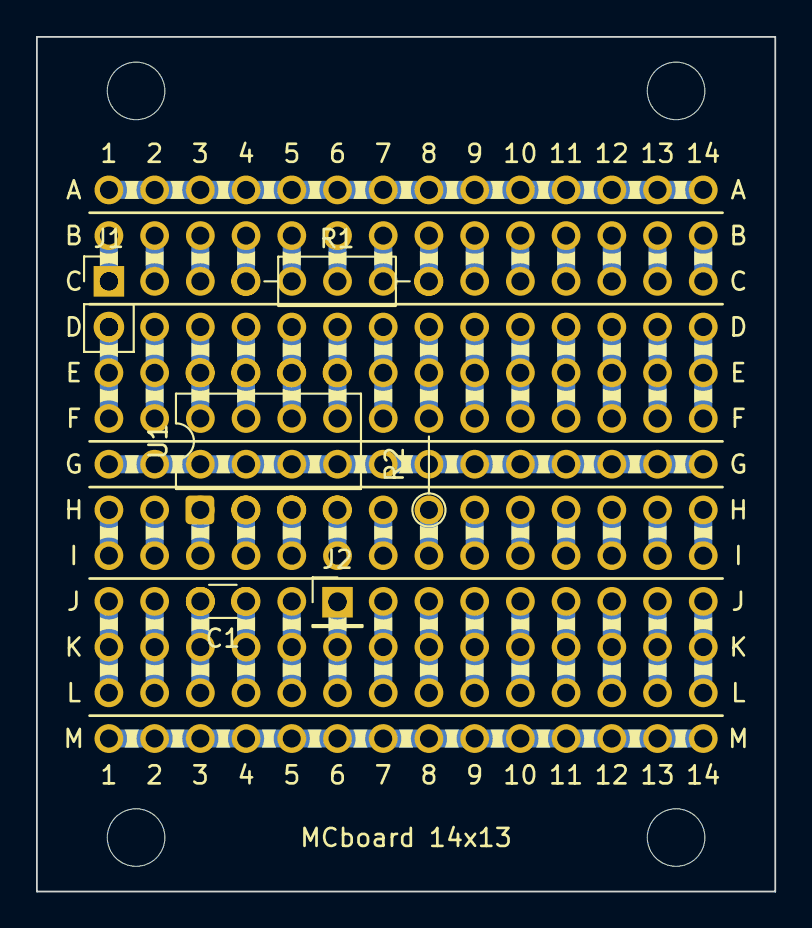
[picture p10: board placed_across_bus.kicad_pcb from above]

Board: 2 copper layers, 41.0 x 47.5 mm, 276 parts (0 on the bottom side), 64 nets.

Parts:
C1: C_Disc_D3.0mm_W1.6mm_P2.50mm
J1: PinHeader_1x02_P2.54mm_Vertical
J2: PinHeader_1x01_P2.54mm_Vertical
PBH1, PBH2, PBH3, PBH4, PBH5, PBH6, PBH7, PBH8, PBH9, PBH10, PBH11, PBH12, PBH13, PBH14, PBH15, PBH16, PBH17, PBH18, PBH19, PBH20, PBH21, PBH22, PBH23, PBH24, PBH25, PBH26, PBH27, PBH28, PBH29, PBH30, PBH31, PBH32, PBH33, PBH34, PBH35, PBH36, PBH37, PBH38, PBH39, PBH40, PBH41, PBH42, PBH43, PBH44, PBH45, PBH46, PBH47, PBH48, PBH49, PBH50, PBH51, PBH52, PBH53, PBH54, PBH55, PBH56, PBH57, PBH58, PBH59, PBH60, PBH61, PBH62, PBH63, PBH64, PBH65, PBH66, PBH67, PBH68, PBH69, PBH70, PBH71, PBH72, PBH73, PBH74, PBH75, PBH76, PBH77, PBH78, PBH79, PBH80, PBH81, PBH82, PBH83, PBH84, PBH85, PBH86, PBH87, PBH88, PBH89, PBH90, PBH91, PBH92, PBH93, PBH94, PBH95, PBH96, PBH97, PBH98, PBH99, PBH100, PBH101, PBH102, PBH103, PBH104, PBH105, PBH106, PBH107, PBH108, PBH109, PBH110, PBH111, PBH112, PBH113, PBH114, PBH115, PBH116, PBH117, PBH118, PBH119, PBH120, PBH121, PBH122, PBH123, PBH124, PBH125, PBH126, PBH127, PBH128, PBH129, PBH130, PBH131, PBH132, PBH133, PBH134, PBH135, PBH136, PBH137, PBH138, PBH139, PBH140, PBH141, PBH142, PBH143, PBH144, PBH145, PBH146, PBH147, PBH148, PBH149, PBH150, PBH151, PBH152, PBH153, PBH154, PBH155, PBH156, PBH157, PBH158, PBH159, PBH160, PBH161, PBH162, PBH163, PBH164, PBH165, PBH166, PBH167, PBH168, PBH169, PBH170, PBH171, PBH172, PBH173, PBH174, PBH175, PBH176, PBH177, PBH178, PBH179, PBH180, PBH181, PBH182: hole; Hole
PBJP1, PBJP2, PBJP3, PBJP4, PBJP5, PBJP6, PBJP7, PBJP8, PBJP9, PBJP10, PBJP11, PBJP12, PBJP13, PBJP14, PBJP15, PBJP16, PBJP17, PBJP18, PBJP19, PBJP20, PBJP21, PBJP22, PBJP23, PBJP24, PBJP25, PBJP26, PBJP27, PBJP28, PBJP29, PBJP30, PBJP31, PBJP32, PBJP33, PBJP34, PBJP35, PBJP36, PBJP37, PBJP38, PBJP39, PBJP40, PBJP41, PBJP42, PBJP43, PBJP44, PBJP45, PBJP46, PBJP47, PBJP48, PBJP49, PBJP50, PBJP51, PBJP52, PBJP53, PBJP54, PBJP55, PBJP56, PBJP57, PBJP58, PBJP59, PBJP60, PBJP61, PBJP62, PBJP63, PBJP64, PBJP65, PBJP66, PBJP67, PBJP68, PBJP69, PBJP70, PBJP71, PBJP72, PBJP73, PBJP74, PBJP75, PBJP76, PBJP77, PBJP78, PBJP79, PBJP80, PBJP81, PBJP82, PBJP83, PBJP84: chevron; ChevronJumper
PBMH1, PBMH2, PBMH3, PBMH4: mounting hole; MountingHole
R1: R_Axial_DIN0207_L6.3mm_D2.5mm_P10.16mm_Horizontal
R2: R_Axial_DIN0204_L3.6mm_D1.6mm_P5.08mm_Vertical
U1: DIP-8_W7.62mm

Connections:
BUS_R1: PBH1.1, PBH14.1, PBH27.1, PBH40.1, PBH53.1, PBH66.1, PBH79.1, PBH92.1, PBH105.1, PBH118.1, PBH131.1, PBH144.1, PBH157.1, PBH170.1, PBJP1.1, PBJP7.1, PBJP13.1, PBJP19.1, PBJP25.1, PBJP31.1, PBJP37.1, PBJP43.1, PBJP49.1, PBJP55.1, PBJP61.1, PBJP67.1, PBJP73.1, PBJP79.1
BUS_R7: PBH7.1, PBH20.1, PBH33.1, PBH46.1, PBH59.1, PBH72.1, PBH85.1, PBH98.1, PBH111.1, PBH124.1, PBH137.1, PBH150.1, PBH163.1, PBH176.1, PBJP3.2, PBJP4.1, PBJP9.2, PBJP10.1, PBJP15.2, PBJP16.1, PBJP21.2, PBJP22.1, PBJP27.2, PBJP28.1, PBJP33.2, PBJP34.1, PBJP39.2, PBJP40.1, PBJP45.2, PBJP46.1, PBJP51.2, PBJP52.1, PBJP57.2, PBJP58.1, PBJP63.2, PBJP64.1, PBJP69.2, PBJP70.1, PBJP75.2, PBJP76.1, PBJP81.2, PBJP82.1
BUS_R13: PBH13.1, PBH26.1, PBH39.1, PBH52.1, PBH65.1, PBH78.1, PBH91.1, PBH104.1, PBH117.1, PBH130.1, PBH143.1, PBH156.1, PBH169.1, PBH182.1, PBJP6.2, PBJP12.2, PBJP18.2, PBJP24.2, PBJP30.2, PBJP36.2, PBJP42.2, PBJP48.2, PBJP54.2, PBJP60.2, PBJP66.2, PBJP72.2, PBJP78.2, PBJP84.2
C1_R2: PBH2.1, PBH3.1, PBJP1.2, PBJP2.1
C1_R4: PBH4.1, PBH5.1, PBH6.1, PBJP2.2, PBJP3.1
C1_R8: PBH8.1, PBH9.1, PBJP4.2, PBJP5.1
C1_R10: PBH10.1, PBH11.1, PBH12.1, PBJP5.2, PBJP6.1
C2_R2: PBH15.1, PBH16.1, PBJP7.2, PBJP8.1
C2_R4: PBH17.1, PBH18.1, PBH19.1, PBJP8.2, PBJP9.1
C2_R8: PBH21.1, PBH22.1, PBJP10.2, PBJP11.1
C2_R10: PBH23.1, PBH24.1, PBH25.1, PBJP11.2, PBJP12.1
C3_R2: PBH28.1, PBH29.1, PBJP13.2, PBJP14.1
C3_R4: PBH30.1, PBH31.1, PBH32.1, PBJP14.2, PBJP15.1
C3_R8: PBH34.1, PBH35.1, PBJP16.2, PBJP17.1
C3_R10: PBH36.1, PBH37.1, PBH38.1, PBJP17.2, PBJP18.1
C4_R2: PBH41.1, PBH42.1, PBJP19.2, PBJP20.1
C4_R4: PBH43.1, PBH44.1, PBH45.1, PBJP20.2, PBJP21.1
C4_R8: PBH47.1, PBH48.1, PBJP22.2, PBJP23.1
C4_R10: PBH49.1, PBH50.1, PBH51.1, PBJP23.2, PBJP24.1
C5_R2: PBH54.1, PBH55.1, PBJP25.2, PBJP26.1
C5_R4: PBH56.1, PBH57.1, PBH58.1, PBJP26.2, PBJP27.1
C5_R8: PBH60.1, PBH61.1, PBJP28.2, PBJP29.1
C5_R10: PBH62.1, PBH63.1, PBH64.1, PBJP29.2, PBJP30.1
C6_R2: PBH67.1, PBH68.1, PBJP31.2, PBJP32.1
C6_R4: PBH69.1, PBH70.1, PBH71.1, PBJP32.2, PBJP33.1
C6_R8: PBH73.1, PBH74.1, PBJP34.2, PBJP35.1
C6_R10: PBH75.1, PBH76.1, PBH77.1, PBJP35.2, PBJP36.1
C7_R2: PBH80.1, PBH81.1, PBJP37.2, PBJP38.1
C7_R4: PBH82.1, PBH83.1, PBH84.1, PBJP38.2, PBJP39.1
C7_R8: PBH86.1, PBH87.1, PBJP40.2, PBJP41.1
C7_R10: PBH88.1, PBH89.1, PBH90.1, PBJP41.2, PBJP42.1
C8_R2: PBH93.1, PBH94.1, PBJP43.2, PBJP44.1
C8_R4: PBH95.1, PBH96.1, PBH97.1, PBJP44.2, PBJP45.1
C8_R8: PBH99.1, PBH100.1, PBJP46.2, PBJP47.1
C8_R10: PBH101.1, PBH102.1, PBH103.1, PBJP47.2, PBJP48.1
C9_R2: PBH106.1, PBH107.1, PBJP49.2, PBJP50.1
C9_R4: PBH108.1, PBH109.1, PBH110.1, PBJP50.2, PBJP51.1
C9_R8: PBH112.1, PBH113.1, PBJP52.2, PBJP53.1
C9_R10: PBH114.1, PBH115.1, PBH116.1, PBJP53.2, PBJP54.1
C10_R2: PBH119.1, PBH120.1, PBJP55.2, PBJP56.1
C10_R4: PBH121.1, PBH122.1, PBH123.1, PBJP56.2, PBJP57.1
C10_R8: PBH125.1, PBH126.1, PBJP58.2, PBJP59.1
C10_R10: PBH127.1, PBH128.1, PBH129.1, PBJP59.2, PBJP60.1
C11_R2: PBH132.1, PBH133.1, PBJP61.2, PBJP62.1
C11_R4: PBH134.1, PBH135.1, PBH136.1, PBJP62.2, PBJP63.1
C11_R8: PBH138.1, PBH139.1, PBJP64.2, PBJP65.1
C11_R10: PBH140.1, PBH141.1, PBH142.1, PBJP65.2, PBJP66.1
C12_R2: PBH145.1, PBH146.1, PBJP67.2, PBJP68.1
C12_R4: PBH147.1, PBH148.1, PBH149.1, PBJP68.2, PBJP69.1
C12_R8: PBH151.1, PBH152.1, PBJP70.2, PBJP71.1
C12_R10: PBH153.1, PBH154.1, PBH155.1, PBJP71.2, PBJP72.1
C13_R2: PBH158.1, PBH159.1, PBJP73.2, PBJP74.1
C13_R4: PBH160.1, PBH161.1, PBH162.1, PBJP74.2, PBJP75.1
C13_R8: PBH164.1, PBH165.1, PBJP76.2, PBJP77.1
C13_R10: PBH166.1, PBH167.1, PBH168.1, PBJP77.2, PBJP78.1
C14_R2: PBH171.1, PBH172.1, PBJP79.2, PBJP80.1
C14_R4: PBH173.1, PBH174.1, PBH175.1, PBJP80.2, PBJP81.1
C14_R8: PBH177.1, PBH178.1, PBJP82.2, PBJP83.1
C14_R10: PBH179.1, PBH180.1, PBH181.1, PBJP83.2, PBJP84.1
DIS: R1.1, R2.2, U1.7
GND: C1.2, J1.2, U1.1
OUT: J2.1, U1.3
TRIG: C1.1, R2.1, U1.2, U1.6
VCC: J1.1, R1.2, U1.4, U1.8
