mcesar67/MCboard/(commit log)

2026-11-08 Initial commit: MCboard protoboard generator and planner
    A parametric solderable protoboard generated as a KiCad project, with the
    Gerbers, drill files and a printable drawing, by a standard-library Python
    script. A planner, also available as a KiCad button, tells which solder
    jumpers to close and which wires to add for a circuit placed on the board.
    Includes the user manual, the design notes, example boards and the
    planner's test boards.
    Claude-Session: https://claude.ai/code/session_01Ka9aXuULs2ujPb6eUJNbpj
    [MCboard_30x19.kicad_pcb, MCboard_64x20.kicad_pcb, imported.kicad_pcb, placed.kicad_pcb, placed_across_bus.kicad_pcb]
2026-11-09 Draw working copy connections as dotted lines; name layers in plan messages
    Working copy: MCboard.Connections (User.1) no longer carries the bars or
    outlines of the silkscreen. It has one thin dotted line through the holes
    of each strip and bus, whatever --silk says, so that placed parts and
    wires stay readable.
    Board files: write group members 10 per line. KiCad failed to load a
    board once that single line reached about 1 MB, around 100x100 holes.
    Planner: when a net cannot be routed, name the strip that is really shut
    in, with its pins, and suggest a manual wire if it has a free hole.
    Messages now give layers as KiCad shows them, such as
    MCboard.ManualWires (User.3).
    PDF: paint the silk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
    [MCboard_30x19.kicad_pcb, MCboard_64x20.kicad_pcb]
2026-11-09 Draw the drills on the working copy's connections layer
    MCboard.Connections (User.1) now has a thin solid circle around every
    drill, mounting holes included, of the same width as the dotted lines,
    so that the holes still show under a part. They are only in the working
    copy and are never fabricated. The plan's PDF skips them, since it draws
    the drills itself.
    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
2026-11-11 Move the plan button to KiCad's IPC API
    The SWIG bindings the button used are deprecated and go in KiCad 11. The
    button is now an IPC API plugin (plugin.json, requirements.txt with
    kicad-python), run by KiCad in a Python environment of its own.
    - plan_action.py replaces action.py. The planner and PDF are unchanged.
    - The API of KiCad 9 cannot add or name a layer nor make groups, so the
    marks are known by the MCboard.Plan layer alone, replaced in one undo
    step, and a board without that layer is refused with a note on how to
    add it.
    - The report is a tkinter window, or <board>_plan.txt without tkinter.
    - The plugin's own packages go first in sys.path: on Linux the system's
    protobuf 4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
    [plan_action.py]
2026-11-11 Install the button for the newest KiCad version by default
    The installer defaulted to 9.0, so after moving to KiCad 10 the button
    went to the folder of the old version. Without --version it now picks
    the newest version folder in KiCad's user folder.
    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
2026-11-11 Add --wire-layers: inner copper layers for wires in the working copy
    The working copy gets MCboard.Wires1 on, from In1.Cu, 2 by default, so that
    wires can later be tracks that KiCad's ratsnest sees, one layer per wire
    colour if wanted. KiCad loads no file with an odd number of copper layers,
    so an odd count is raised by one, with a message. The board for ordering
    keeps its two copper layers.
    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
2026-11-11 Add apply, clear and nets buttons, wire layers and KiCad 10 format
    - KiCad buttons: apply puts the plan into the working copy's copper as
    locked tracks on inner layers MCboard.Wires<n> and MCboard.Chevrons,
    so the ratsnest shows only what is left; clear removes the plan and
    the applied tracks; MCboard nets updates the nets of what was drawn
    by hand, without planning. Applied tracks take the width of the
    project's Default net class.
    - Working copy user layers moved to User.5-7; the old manual lines on
    User.1/User.2 are gone.
    - Reports from all buttons open in one browser tab (report_server.py).
    - Plan PDF: wire colour per layer, magenta chevrons, dashed chevrons
    on the other sid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
    [MCboard_30x19.kicad_pcb, MCboard_64x20.kicad_pcb]
